sophiekovalevsky/LibreVNA/pr-previews/2/3483b7b/VNA.3dmodels/LP0603N3500ANTR.stp

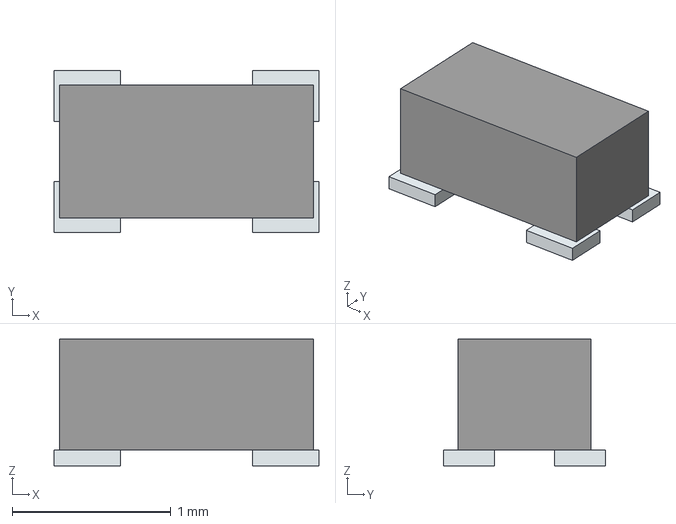
[picture p1: CAD file, 2025-08-09]
pr-previews/2/3483b7b/VNA.3dmodels/LP0603N3500ANTR.stp
1.67 x 1.02 x 0.8 mm
Pins
