sophiekovalevsky/LibreVNA/pr-previews/2/3483b7b/VNA.3dmodels/TCM1-63AX_.step

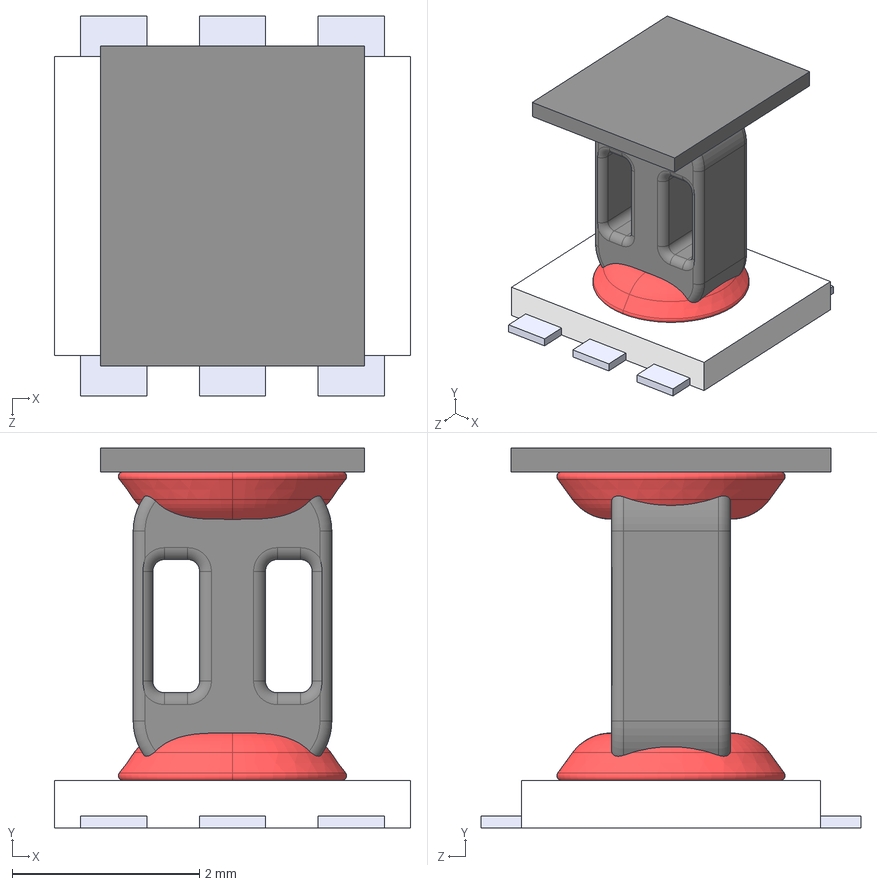
[picture p2: CAD file, 2025-08-09]
pr-previews/2/3483b7b/VNA.3dmodels/TCM1-63AX_.step
3.81 x 4.06 x 4.06 mm
