sophiekovalevsky/LibreVNA/pr-previews/2/5cce5da/VNA.3dmodels/PJ-014D.stp

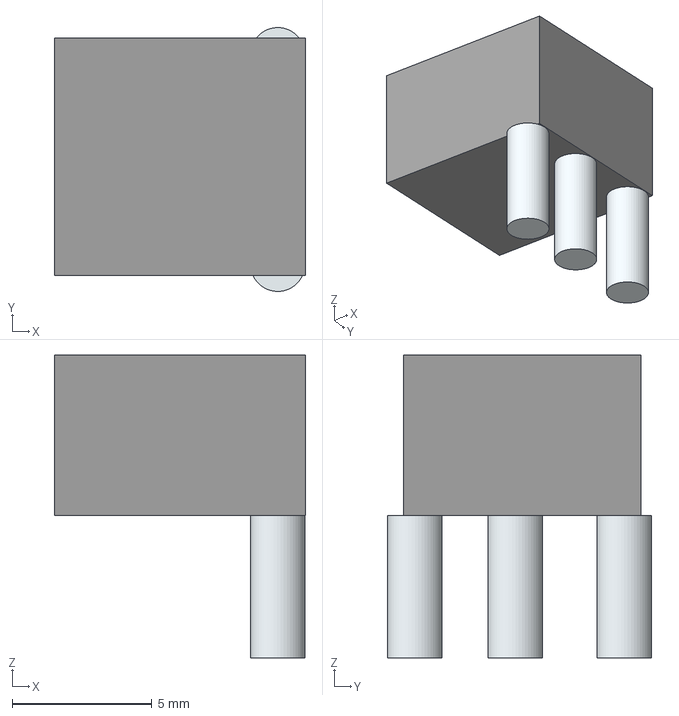
[picture p3: CAD file, 2025-08-09]
pr-previews/2/5cce5da/VNA.3dmodels/PJ-014D.stp
9.00 x 9.45 x 10.8 mm
Leads
