sophiekovalevsky/LibreVNA/pr-previews/2/3483b7b/VNA.3dmodels/PAT0816-C-3DB-T5.STEP

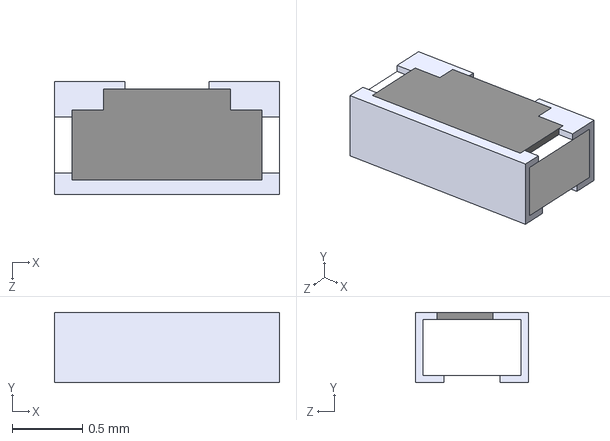
[picture p4: CAD file, 2025-08-09]
pr-previews/2/3483b7b/VNA.3dmodels/PAT0816-C-3DB-T5.STEP
1.60 x 0.5 x 0.8 mm
