sophiekovalevsky/LibreVNA/pr-previews/2/3483b7b/VNA.kicad_pcb

## KiCad design pr-previews/2/3483b7b/VNA.kicad_pcb (2025-08-09)

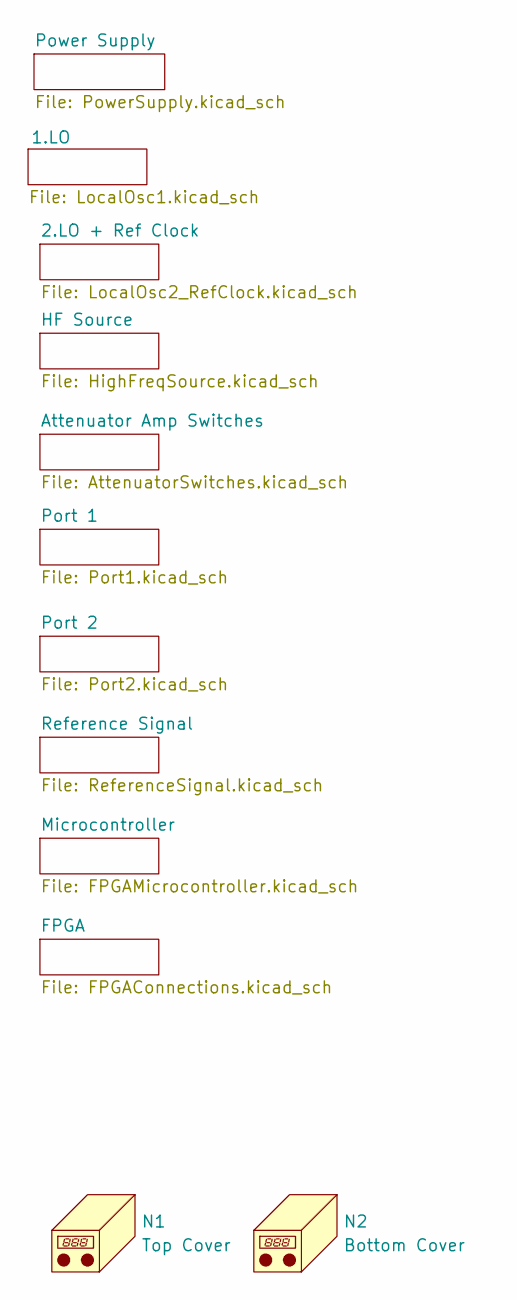
[picture p5: schematic VNA.kicad_sch, Root]

Parts:
N1: Top Cover; VNA_COVER_TOP
N2: Bottom Cover; VNA_COVER_BOTTOM

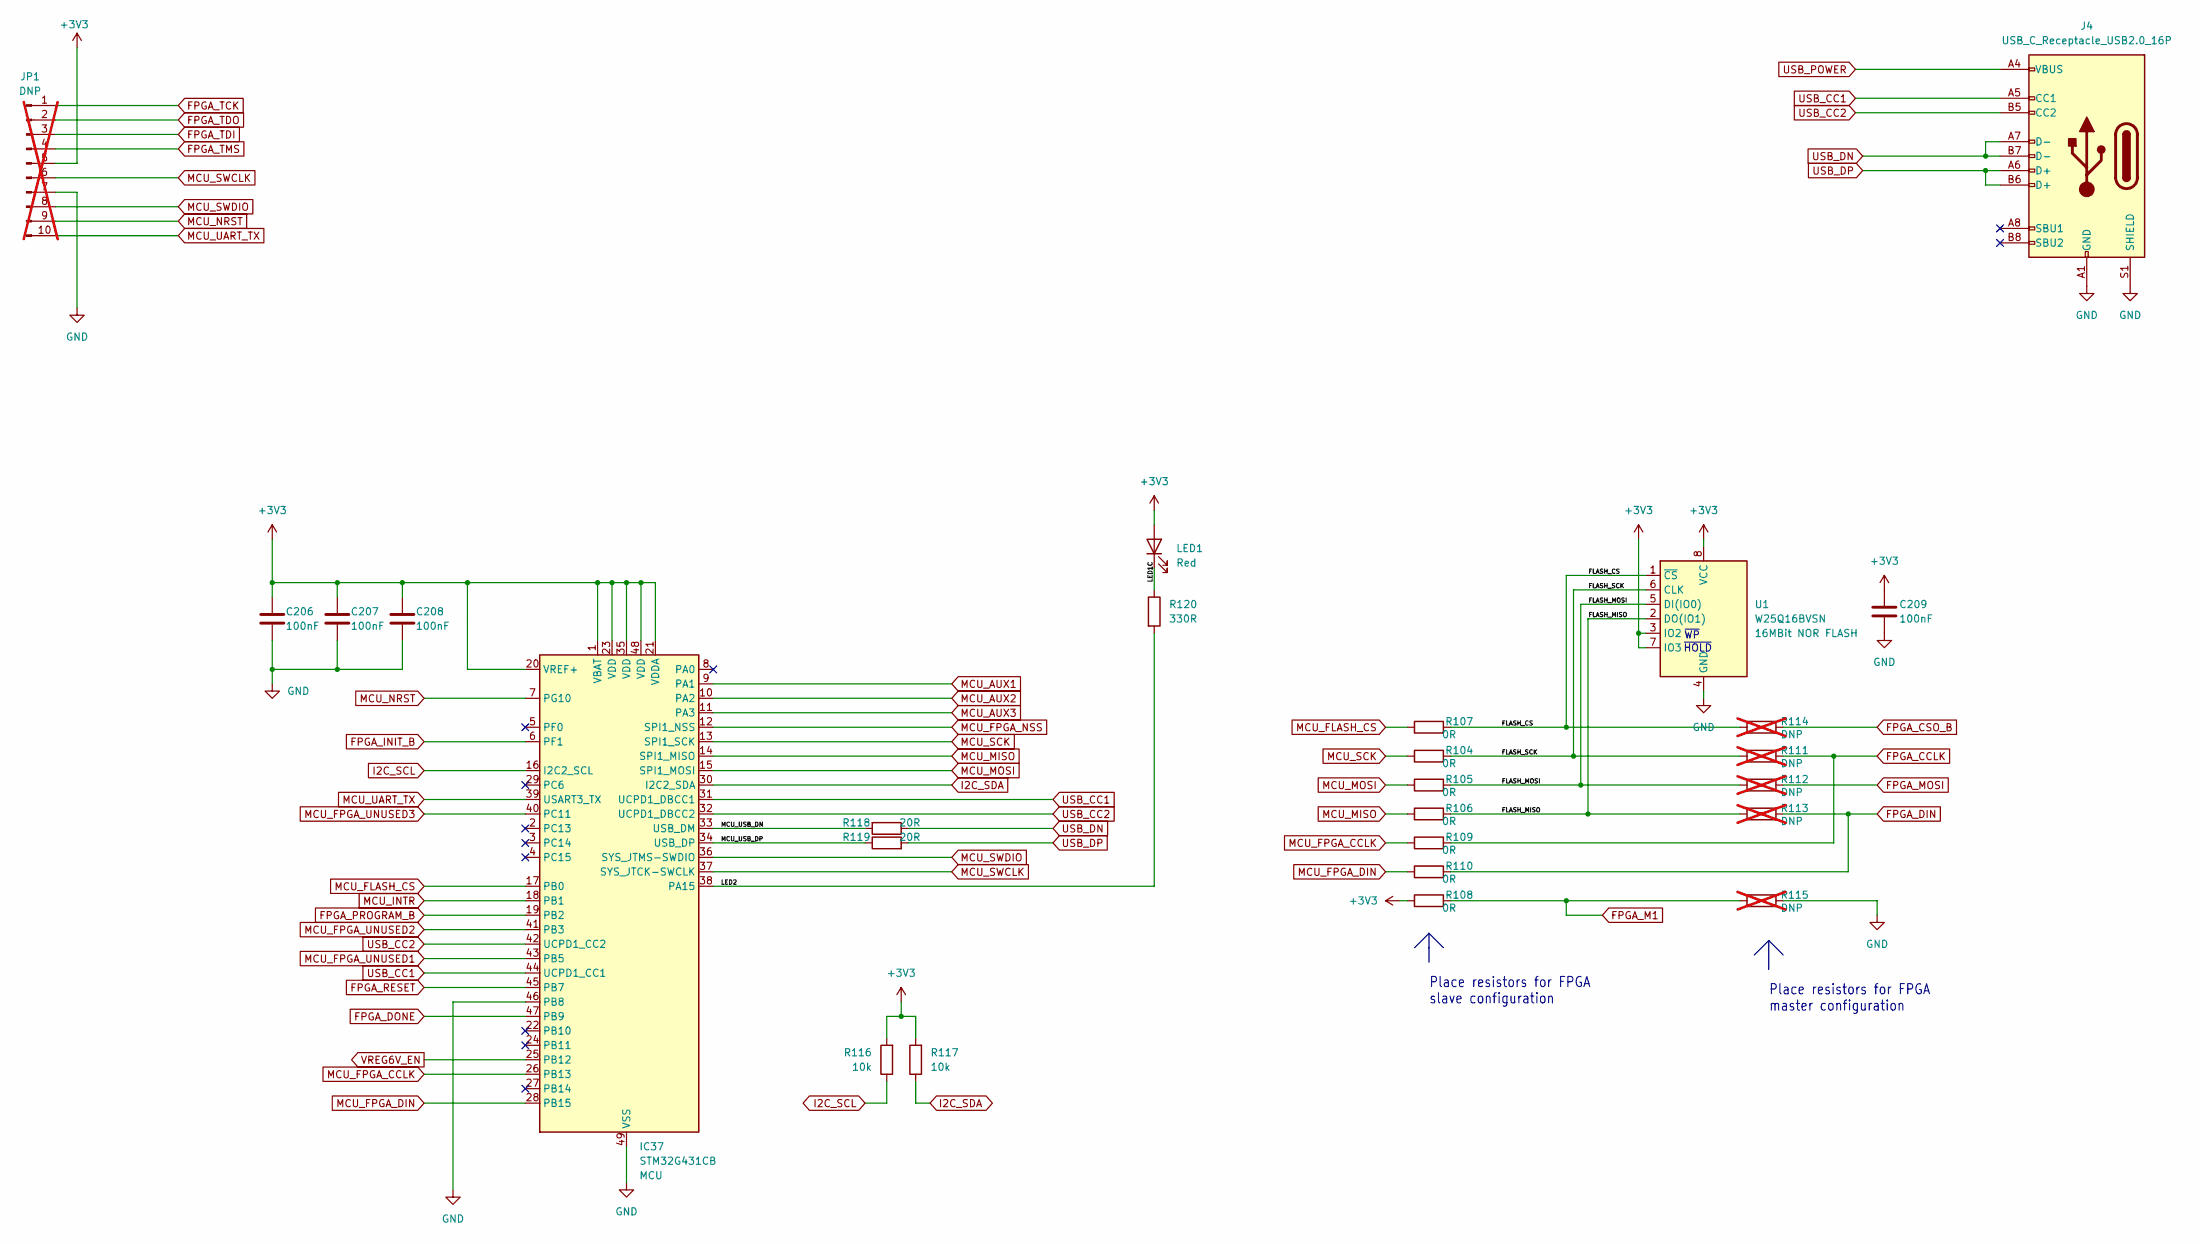
[picture p6: schematic FPGAMicrocontroller.kicad_sch, FPGA + MCU Connections]

Parts:
C206, C207, C208, C209: 100nF; C_0402_1005Metric
IC37: STM32G431CB; QFN-48-1EP_7x7mm_P0.5mm_EP5.6x5.6mm; MPN STM32G431CBU6
J4: USB_C_Receptacle_USB2.0_16P; USB_C_Receptacle_GCT_USB4105-xx-A_16P_TopMnt_Horizontal; MPN LCSC C668624
JP1: DNP; PinHeader_1x10_P2.54mm_Horizontal; not fitted
LED1: Red; LED_0603_1608Metric
R104, R105, R106, R107, R108, R109, R110: 0R; R_0402_1005Metric
R111, R112, R113, R114, R115: DNP; R_0402_1005Metric; not fitted
R116, R117: 10k; R_0402_1005Metric
R118, R119: 20R; R_0402_1005Metric
R120: 330R; R_0402_1005Metric
U1: W25Q16BVSN; SOIC-8_3.9x4.9mm_P1.27mm; MPN W25Q16JL

Connections:
+3V3: C206.1, C207.1, C208.1, C209.1, IC37.1 (VBAT), IC37.20 (VREF+), IC37.21 (VDDA), IC37.23 (VDD), IC37.35 (VDD), IC37.48 (VDD), JP1.5, LED1.2 (A), R108.1, R116.2, R117.2, U1.3 (IO2), U1.7 (IO3), U1.8 (VCC); also elsewhere on the board
/Microcontroller/FLASH_CS: R107.2, R114.1, U1.1 (~CS)
/Microcontroller/FLASH_MISO: R106.2, R113.1, U1.2 (DO(IO1))
/Microcontroller/FLASH_MOSI: R105.2, R112.1, U1.5 (DI(IO0))
/Microcontroller/FLASH_SCK: R104.2, R111.1, U1.6 (CLK)
/Microcontroller/LED1C: LED1.1 (K), R120.1
/Microcontroller/LED2: IC37.38 (PA15), R120.2
/Microcontroller/MCU_USB_DN: IC37.33 (USB_DM), R118.2
/Microcontroller/MCU_USB_DP: IC37.34 (USB_DP), R119.1
FPGA_CCLK: R109.2, R111.2; also elsewhere on the board
FPGA_CSO_B: R114.2; also elsewhere on the board
FPGA_DIN: R110.2, R113.2; also elsewhere on the board
FPGA_DONE: IC37.47 (PB9); also elsewhere on the board
FPGA_INIT_B: IC37.6 (PF1); also elsewhere on the board
FPGA_M1: R108.2, R115.1; also elsewhere on the board
FPGA_MOSI: R112.2; also elsewhere on the board
FPGA_PROGRAM_B: IC37.19 (PB2); also elsewhere on the board
FPGA_RESET: IC37.45 (PB7); also elsewhere on the board
FPGA_TCK: JP1.1; also elsewhere on the board
FPGA_TDI: JP1.3; also elsewhere on the board
FPGA_TDO: JP1.2; also elsewhere on the board
FPGA_TMS: JP1.4; also elsewhere on the board
GND: C206.2, C207.2, C208.2, C209.2, IC37.46 (PB8), IC37.49 (VSS), J4.A1 (GND), J4.A12 (GND), J4.B1 (GND), J4.B12 (GND), J4.S1 (SHIELD), JP1.7, R115.2, U1.4 (GND); also elsewhere on the board
I2C_SCL: IC37.16 (I2C2_SCL), R116.1; also elsewhere on the board
I2C_SDA: IC37.30 (I2C2_SDA), R117.1; also elsewhere on the board
MCU_AUX1: IC37.9 (PA1); also elsewhere on the board
MCU_AUX2: IC37.10 (PA2); also elsewhere on the board
MCU_AUX3: IC37.11 (PA3); also elsewhere on the board
MCU_FLASH_CS: IC37.17 (PB0), R107.1
MCU_FPGA_CCLK: IC37.26 (PB13), R109.1
MCU_FPGA_DIN: IC37.28 (PB15), R110.1
MCU_FPGA_NSS: IC37.12 (SPI1_NSS); also elsewhere on the board
MCU_FPGA_UNUSED1: IC37.43 (PB5); also elsewhere on the board
MCU_FPGA_UNUSED2: IC37.41 (PB3); also elsewhere on the board
MCU_FPGA_UNUSED3: IC37.40 (PC11); also elsewhere on the board
MCU_INTR: IC37.18 (PB1); also elsewhere on the board
MCU_MISO: IC37.14 (SPI1_MISO), R106.1; also elsewhere on the board
MCU_MOSI: IC37.15 (SPI1_MOSI), R105.1; also elsewhere on the board
MCU_NRST: IC37.7 (PG10), JP1.9
MCU_SCK: IC37.13 (SPI1_SCK), R104.1; also elsewhere on the board
MCU_SWCLK: IC37.37 (SYS_JTCK-SWCLK), JP1.6
MCU_SWDIO: IC37.36 (SYS_JTMS-SWDIO), JP1.8
MCU_UART_TX: IC37.39 (USART3_TX), JP1.10
USB_CC1: IC37.31 (UCPD1_DBCC1), IC37.44 (UCPD1_CC1), J4.A5 (CC1)
USB_CC2: IC37.32 (UCPD1_DBCC2), IC37.42 (UCPD1_CC2), J4.B5 (CC2)
USB_DN: J4.A7 (D-), J4.B7 (D-), R118.1
USB_DP: J4.A6 (D+), J4.B6 (D+), R119.2
USB_POWER: J4.A4 (VBUS), J4.A9 (VBUS), J4.B4 (VBUS), J4.B9 (VBUS); also elsewhere on the board
VREG6V_EN: IC37.25 (PB12); also elsewhere on the board

Notes on the sheet:
Place resistors for FPGA slave configuration
~{WP}
Place resistors for FPGA master configuration
~{HOLD}

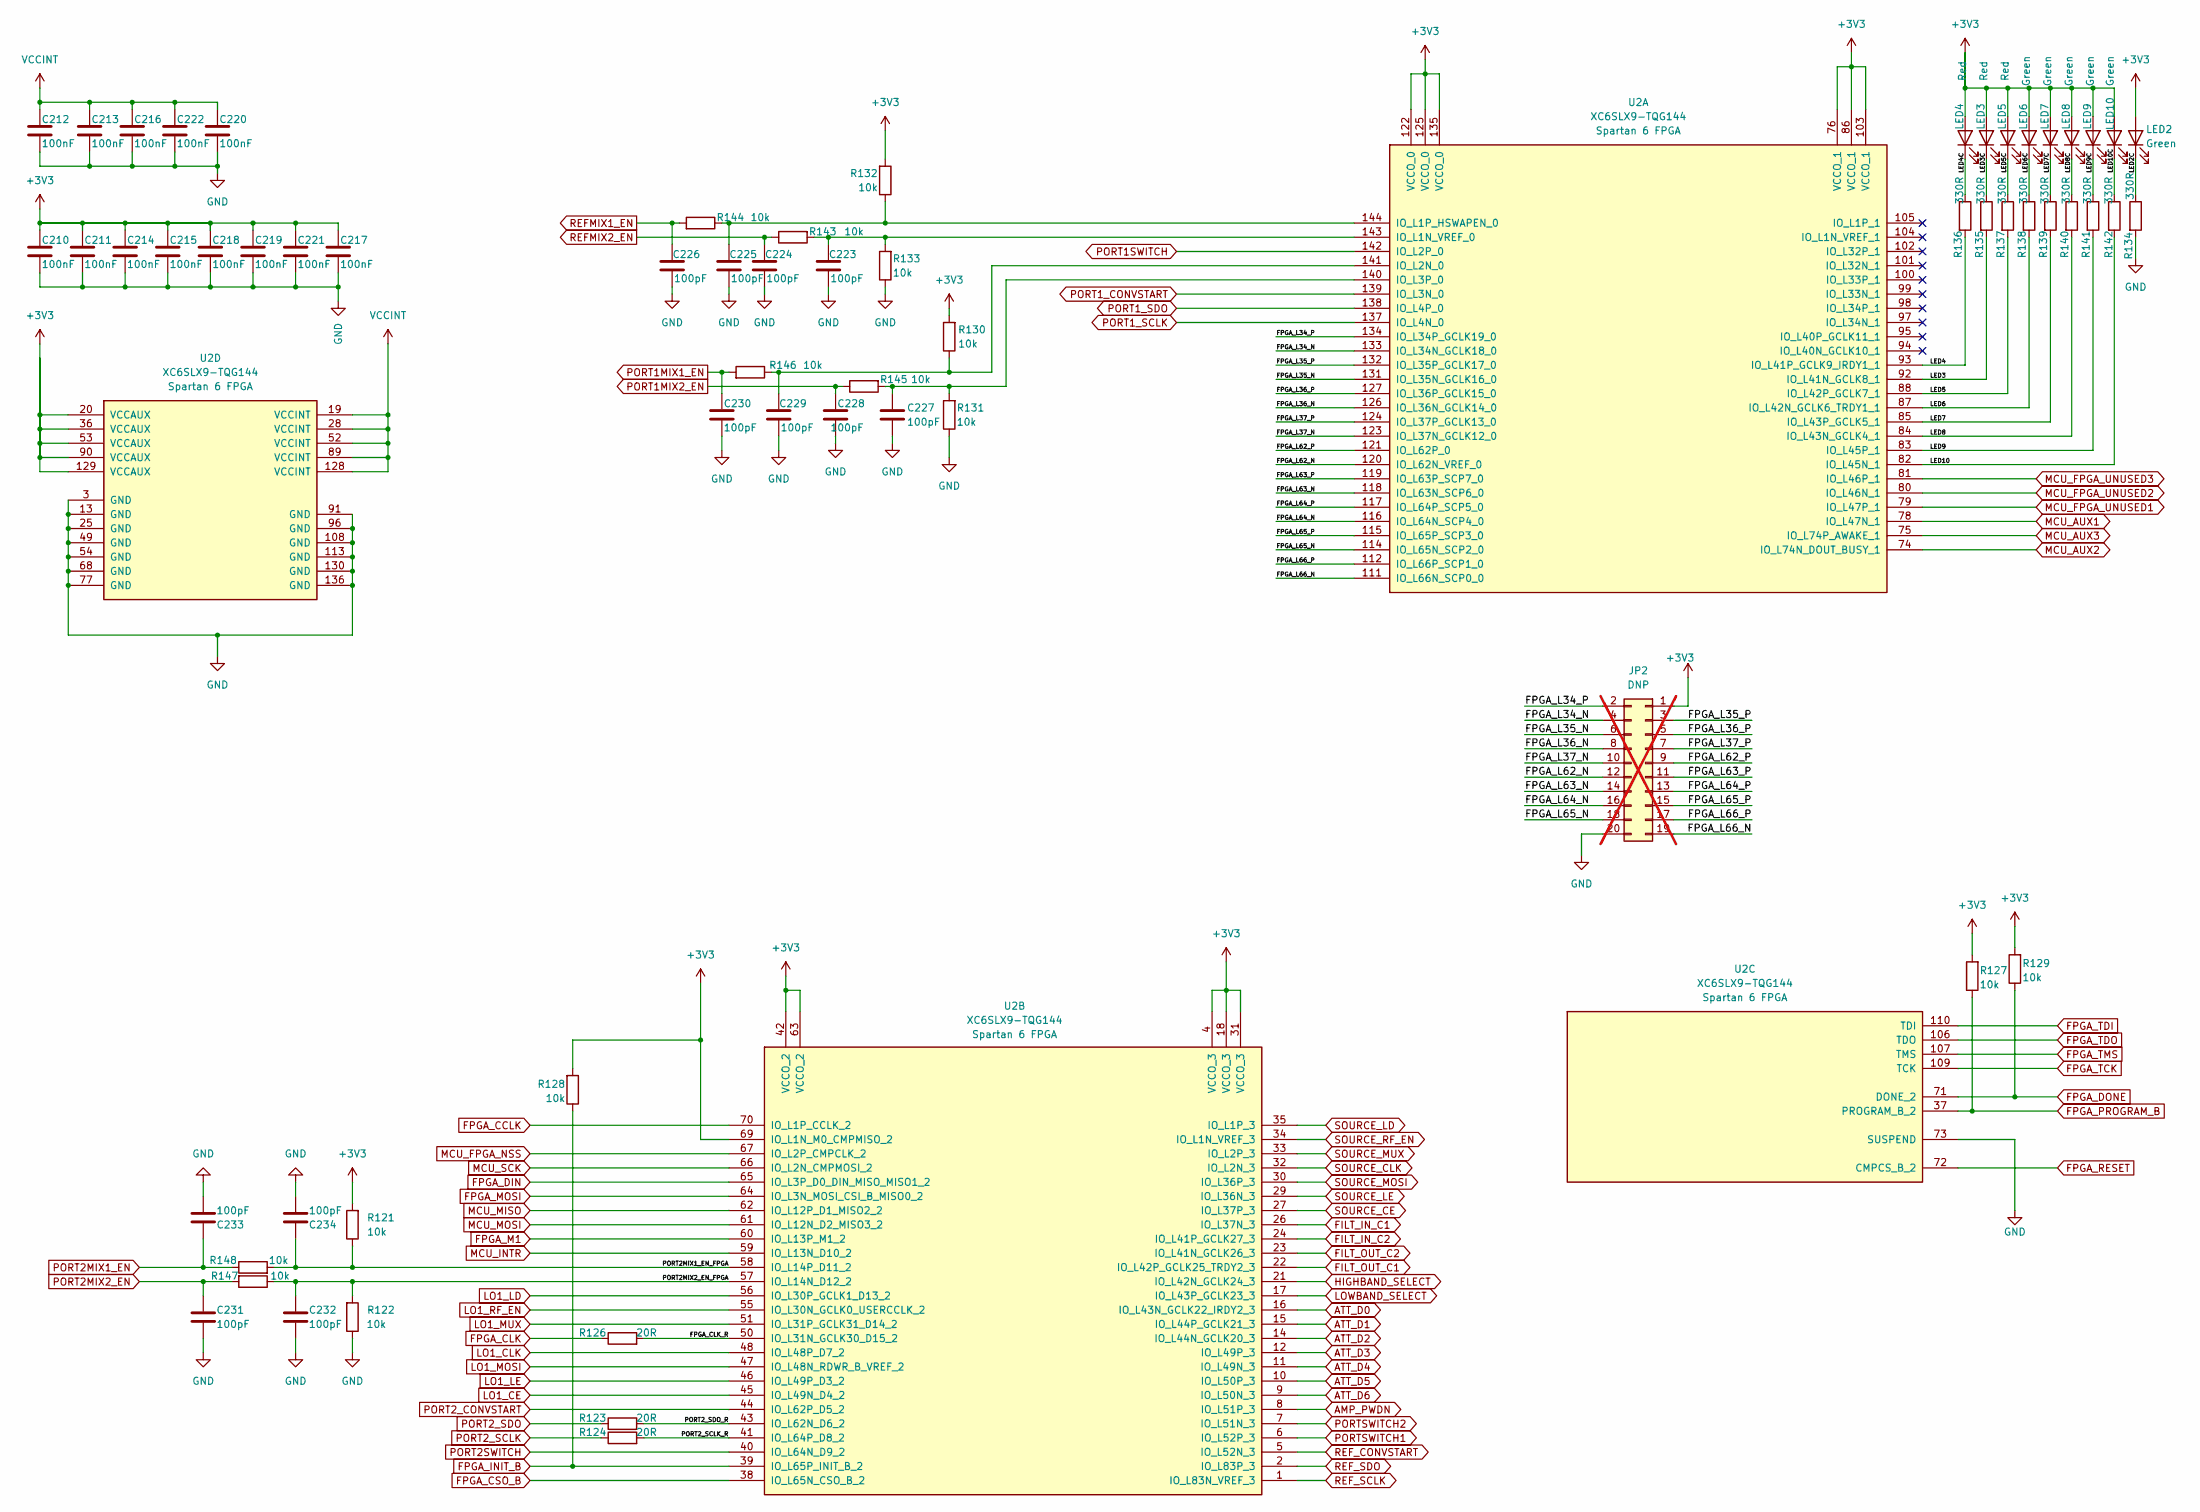
[picture p7: schematic FPGAConnections.kicad_sch, FPGA Connections]

Parts:
C210, C211, C212, C213, C214, C215, C216, C217, C218, C219, C220, C221, C222: 100nF; C_0402_1005Metric
C223, C224, C225, C226, C227, C228, C229, C230, C231, C232, C233, C234: 100pF; C_0402_1005Metric
JP2: DNP; PinHeader_2x10_P2.54mm_Vertical; not fitted
LED2, LED6, LED7, LED8, LED9, LED10: Green; LED_0603_1608Metric
LED3, LED4, LED5: Red; LED_0603_1608Metric
R121, R122, R127, R128, R129, R130, R131, R132, R133, R143, R144, R145, R146, R147, R148: 10k; R_0402_1005Metric
R123, R124, R126: 20R; R_0402_1005Metric
R134, R135, R136, R137, R138, R139, R140, R141, R142: 330R; R_0402_1005Metric
U2: XC6SLX9-TQG144; TQFP-144_20x20mm_P0.5mm; MPN XC6SLX9-2TQG144

Connections:
+3V3: C210.1, C211.1, C214.1, C215.1, C217.1, C218.1, C219.1, C221.1, JP2.1, LED2.2 (A), LED3.2 (A), LED4.2 (A), LED5.2 (A), LED6.2 (A), LED7.2 (A), LED8.2 (A), LED9.2 (A), LED10.2 (A), R121.2, R127.2, R128.2, R129.2, R130.2, R132.2, U2.4 (VCCO_3), U2.18 (VCCO_3), U2.20 (VCCAUX), U2.31 (VCCO_3), U2.36 (VCCAUX), U2.42 (VCCO_2), U2.53 (VCCAUX), U2.63 (VCCO_2), U2.69 (IO_L1N_M0_CMPMISO_2), U2.76 (VCCO_1), U2.86 (VCCO_1), U2.90 (VCCAUX), U2.103 (VCCO_1), U2.122 (VCCO_0), U2.125 (VCCO_0), U2.129 (VCCAUX), U2.135 (VCCO_0); also elsewhere on the board
/FPGA/FPGA_CLK_R: R126.2, U2.50 (IO_L31N_GCLK30_D15_2)
/FPGA/FPGA_L34_N: JP2.4, U2.133 (IO_L34N_GCLK18_0)
/FPGA/FPGA_L34_P: JP2.2, U2.134 (IO_L34P_GCLK19_0)
/FPGA/FPGA_L35_N: JP2.6, U2.131 (IO_L35N_GCLK16_0)
/FPGA/FPGA_L35_P: JP2.3, U2.132 (IO_L35P_GCLK17_0)
/FPGA/FPGA_L36_N: JP2.8, U2.126 (IO_L36N_GCLK14_0)
/FPGA/FPGA_L36_P: JP2.5, U2.127 (IO_L36P_GCLK15_0)
/FPGA/FPGA_L37_N: JP2.10, U2.123 (IO_L37N_GCLK12_0)
/FPGA/FPGA_L37_P: JP2.7, U2.124 (IO_L37P_GCLK13_0)
/FPGA/FPGA_L62_N: JP2.12, U2.120 (IO_L62N_VREF_0)
/FPGA/FPGA_L62_P: JP2.9, U2.121 (IO_L62P_0)
/FPGA/FPGA_L63_N: JP2.14, U2.118 (IO_L63N_SCP6_0)
/FPGA/FPGA_L63_P: JP2.11, U2.119 (IO_L63P_SCP7_0)
/FPGA/FPGA_L64_N: JP2.16, U2.116 (IO_L64N_SCP4_0)
/FPGA/FPGA_L64_P: JP2.13, U2.117 (IO_L64P_SCP5_0)
/FPGA/FPGA_L65_N: JP2.18, U2.114 (IO_L65N_SCP2_0)
/FPGA/FPGA_L65_P: JP2.15, U2.115 (IO_L65P_SCP3_0)
/FPGA/FPGA_L66_N: JP2.19, U2.111 (IO_L66N_SCP0_0)
/FPGA/FPGA_L66_P: JP2.17, U2.112 (IO_L66P_SCP1_0)
/FPGA/LED2C: LED2.1 (K), R134.1
/FPGA/LED3: R135.2, U2.92 (IO_L41N_GCLK8_1)
/FPGA/LED3C: LED3.1 (K), R135.1
/FPGA/LED4: R136.2, U2.93 (IO_L41P_GCLK9_IRDY1_1)
/FPGA/LED4C: LED4.1 (K), R136.1
/FPGA/LED5: R137.2, U2.88 (IO_L42P_GCLK7_1)
/FPGA/LED5C: LED5.1 (K), R137.1
/FPGA/LED6: R138.2, U2.87 (IO_L42N_GCLK6_TRDY1_1)
/FPGA/LED6C: LED6.1 (K), R138.1
/FPGA/LED7: R139.2, U2.85 (IO_L43P_GCLK5_1)
/FPGA/LED7C: LED7.1 (K), R139.1
/FPGA/LED8: R140.2, U2.84 (IO_L43N_GCLK4_1)
/FPGA/LED8C: LED8.1 (K), R140.1
/FPGA/LED9: R141.2, U2.83 (IO_L45P_1)
/FPGA/LED9C: LED9.1 (K), R141.1
/FPGA/LED10: R142.2, U2.82 (IO_L45N_1)
/FPGA/LED10C: LED10.1 (K), R142.1
/FPGA/PORT2MIX1_EN_FPGA: C234.1, R121.1, R148.2, U2.58 (IO_L14P_D11_2)
/FPGA/PORT2MIX2_EN_FPGA: C232.1, R122.2, R147.1, U2.57 (IO_L14N_D12_2)
/FPGA/PORT2_SCLK_R: R124.2, U2.41 (IO_L64P_D8_2)
/FPGA/PORT2_SDO_R: R123.2, U2.43 (IO_L62N_D6_2)
AMP_PWDN: U2.8 (IO_L51P_3); also elsewhere on the board
ATT_D0: U2.16 (IO_L43N_GCLK22_IRDY2_3); also elsewhere on the board
ATT_D1: U2.15 (IO_L44P_GCLK21_3); also elsewhere on the board
ATT_D2: U2.14 (IO_L44N_GCLK20_3); also elsewhere on the board
ATT_D3: U2.12 (IO_L49P_3); also elsewhere on the board
ATT_D4: U2.11 (IO_L49N_3); also elsewhere on the board
ATT_D5: U2.10 (IO_L50P_3); also elsewhere on the board
ATT_D6: U2.9 (IO_L50N_3); also elsewhere on the board
FILT_IN_C1: U2.26 (IO_L37N_3); also elsewhere on the board
FILT_IN_C2: U2.24 (IO_L41P_GCLK27_3); also elsewhere on the board
FILT_OUT_C1: U2.22 (IO_L42P_GCLK25_TRDY2_3); also elsewhere on the board
FILT_OUT_C2: U2.23 (IO_L41N_GCLK26_3); also elsewhere on the board
FPGA_CCLK: U2.70 (IO_L1P_CCLK_2); also elsewhere on the board
FPGA_CLK: R126.1; also elsewhere on the board
FPGA_CSO_B: U2.38 (IO_L65N_CSO_B_2); also elsewhere on the board
FPGA_DIN: U2.65 (IO_L3P_D0_DIN_MISO_MISO1_2); also elsewhere on the board
FPGA_DONE: R129.1, U2.71 (DONE_2); also elsewhere on the board
FPGA_INIT_B: R128.1, U2.39 (IO_L65P_INIT_B_2); also elsewhere on the board
FPGA_M1: U2.60 (IO_L13P_M1_2); also elsewhere on the board
FPGA_MOSI: U2.64 (IO_L3N_MOSI_CSI_B_MISO0_2); also elsewhere on the board
FPGA_PROGRAM_B: R127.1, U2.37 (PROGRAM_B_2); also elsewhere on the board
FPGA_RESET: U2.72 (CMPCS_B_2); also elsewhere on the board
FPGA_TCK: U2.109 (TCK); also elsewhere on the board
FPGA_TDI: U2.110 (TDI); also elsewhere on the board
FPGA_TDO: U2.106 (TDO); also elsewhere on the board
FPGA_TMS: U2.107 (TMS); also elsewhere on the board
GND: C210.2, C211.2, C212.2, C213.2, C214.2, C215.2, C216.2, C217.2, C218.2, C219.2, C220.2, C221.2, C222.2, C223.2, C224.2, C225.2, C226.2, C227.2, C228.2, C229.2, C230.2, C231.2, C232.2, C233.2, C234.2, JP2.20, R122.1, R131.1, R133.1, R134.2, U2.3 (GND), U2.13 (GND), U2.25 (GND), U2.49 (GND), U2.54 (GND), U2.68 (GND), U2.73 (SUSPEND), U2.77 (GND), U2.91 (GND), U2.96 (GND), U2.108 (GND), U2.113 (GND), U2.130 (GND), U2.136 (GND); also elsewhere on the board
HIGHBAND_SELECT: U2.21 (IO_L42N_GCLK24_3); also elsewhere on the board
LO1_CE: U2.45 (IO_L49N_D4_2); also elsewhere on the board
LO1_CLK: U2.48 (IO_L48P_D7_2); also elsewhere on the board
LO1_LD: U2.56 (IO_L30P_GCLK1_D13_2); also elsewhere on the board
LO1_LE: U2.46 (IO_L49P_D3_2); also elsewhere on the board
LO1_MOSI: U2.47 (IO_L48N_RDWR_B_VREF_2); also elsewhere on the board
LO1_MUX: U2.51 (IO_L31P_GCLK31_D14_2); also elsewhere on the board
LO1_RF_EN: U2.55 (IO_L30N_GCLK0_USERCCLK_2); also elsewhere on the board
LOWBAND_SELECT: U2.17 (IO_L43P_GCLK23_3); also elsewhere on the board
MCU_AUX1: U2.78 (IO_L47N_1); also elsewhere on the board
MCU_AUX2: U2.74 (IO_L74N_DOUT_BUSY_1); also elsewhere on the board
MCU_AUX3: U2.75 (IO_L74P_AWAKE_1); also elsewhere on the board
MCU_FPGA_NSS: U2.67 (IO_L2P_CMPCLK_2); also elsewhere on the board
MCU_FPGA_UNUSED1: U2.79 (IO_L47P_1); also elsewhere on the board
MCU_FPGA_UNUSED2: U2.80 (IO_L46N_1); also elsewhere on the board
MCU_FPGA_UNUSED3: U2.81 (IO_L46P_1); also elsewhere on the board
MCU_INTR: U2.59 (IO_L13N_D10_2); also elsewhere on the board
MCU_MISO: U2.62 (IO_L12P_D1_MISO2_2); also elsewhere on the board
MCU_MOSI: U2.61 (IO_L12N_D2_MISO3_2); also elsewhere on the board
MCU_SCK: U2.66 (IO_L2N_CMPMOSI_2); also elsewhere on the board
unnamed: C223.1, R133.2, R143.2, U2.143 (IO_L1N_VREF_0)
unnamed: C225.1, R132.1, R144.1, U2.144 (IO_L1P_HSWAPEN_0)
unnamed: C229.1, R130.1, R146.1, U2.141 (IO_L2N_0)
unnamed: C227.1, R131.2, R145.2, U2.140 (IO_L3P_0)
PORT1MIX1_EN: C230.1, R146.2; also elsewhere on the board
PORT1MIX2_EN: C228.1, R145.1; also elsewhere on the board
PORT1SWITCH: U2.142 (IO_L2P_0); also elsewhere on the board
PORT1_CONVSTART: U2.139 (IO_L3N_0); also elsewhere on the board
PORT1_SCLK: U2.137 (IO_L4N_0); also elsewhere on the board
PORT1_SDO: U2.138 (IO_L4P_0); also elsewhere on the board
PORT2MIX1_EN: C233.1, R148.1; also elsewhere on the board
PORT2MIX2_EN: C231.1, R147.2; also elsewhere on the board
PORT2SWITCH: U2.40 (IO_L64N_D9_2); also elsewhere on the board
PORT2_CONVSTART: U2.44 (IO_L62P_D5_2); also elsewhere on the board
PORT2_SCLK: R124.1; also elsewhere on the board
PORT2_SDO: R123.1; also elsewhere on the board
PORTSWITCH1: U2.6 (IO_L52P_3); also elsewhere on the board
PORTSWITCH2: U2.7 (IO_L51N_3); also elsewhere on the board
REFMIX1_EN: C226.1, R144.2; also elsewhere on the board
REFMIX2_EN: C224.1, R143.1; also elsewhere on the board
REF_CONVSTART: U2.5 (IO_L52N_3); also elsewhere on the board
REF_SCLK: U2.1 (IO_L83N_VREF_3); also elsewhere on the board
REF_SDO: U2.2 (IO_L83P_3); also elsewhere on the board
SOURCE_CE: U2.27 (IO_L37P_3); also elsewhere on the board
SOURCE_CLK: U2.32 (IO_L2N_3); also elsewhere on the board
SOURCE_LD: U2.35 (IO_L1P_3); also elsewhere on the board
SOURCE_LE: U2.29 (IO_L36N_3); also elsewhere on the board
SOURCE_MOSI: U2.30 (IO_L36P_3); also elsewhere on the board
SOURCE_MUX: U2.33 (IO_L2P_3); also elsewhere on the board
SOURCE_RF_EN: U2.34 (IO_L1N_VREF_3); also elsewhere on the board
VCCINT: C212.1, C213.1, C216.1, C220.1, C222.1, U2.19 (VCCINT), U2.28 (VCCINT), U2.52 (VCCINT), U2.89 (VCCINT), U2.128 (VCCINT); also elsewhere on the board

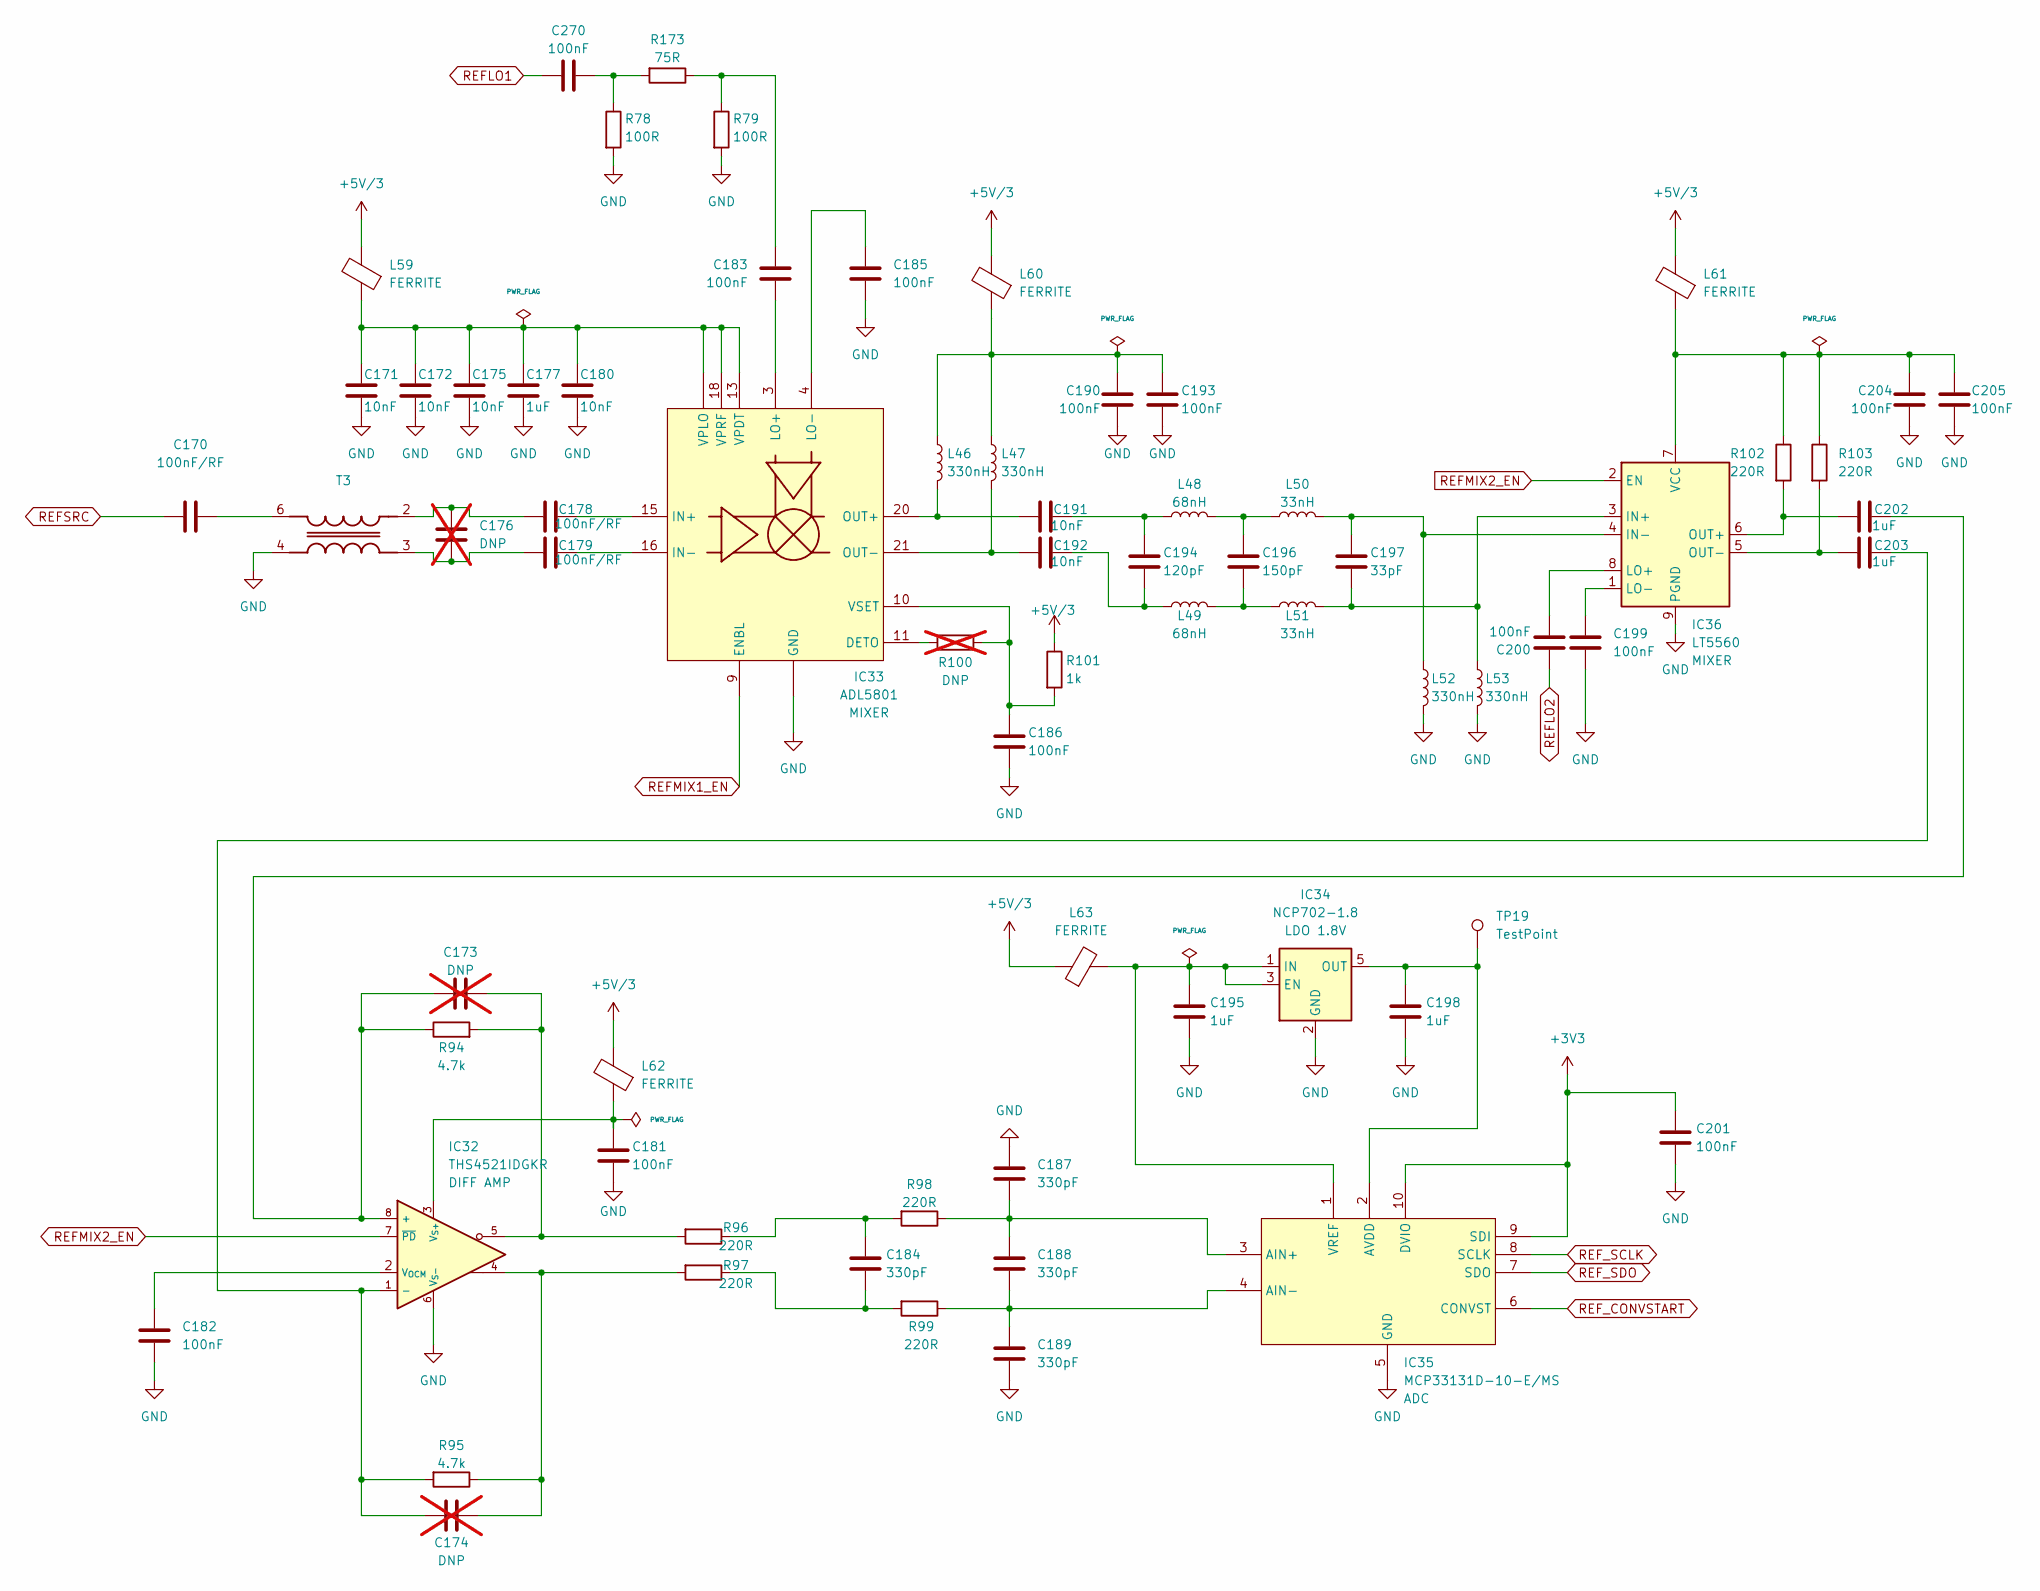
[picture p8: schematic ReferenceSignal.kicad_sch, Reference Signal]

Parts:
C170, C178, C179: 100nF/RF; C_0402_1005Metric
C171, C172, C175, C180, C191, C192: 10nF; C_0402_1005Metric
C173, C174, C176: DNP; C_0402_1005Metric; not fitted
C177, C195, C198, C202, C203: 1uF; C_0402_1005Metric
C181, C182, C183, C185, C186, C190, C193, C199, C200, C201, C204, C205, C270: 100nF; C_0402_1005Metric
C184, C187, C188, C189: 330pF; C_0402_1005Metric
C194: 120pF; C_0402_1005Metric
C196: 150pF; C_0402_1005Metric
C197: 33pF; C_0402_1005Metric
IC32: THS4521IDGKR; VSSOP-8_3.0x3.0mm_P0.65mm; MPN THS4521IDGKR
IC33: ADL5801; QFN-24-1EP_4x4mm_P0.5mm_EP2.6x2.6mm; MPN ADL5801
IC34: NCP702-1.8; SOT-23-5; MPN NCP702SN18T1G
IC35: MCP33131D-10-E/MS; VSSOP-10_3x3mm_P0.5mm; MPN MCP33131D-10-E/MS
IC36: LT5560; WSON-8-1EP_3x3mm_P0.5mm_EP1.45x2.4mm; MPN LT5560EDD
L46, L47, L52, L53: 330nH; L_0402_1005Metric; MPN LQW15CNR33J10D
L48, L49: 68nH; L_0402_1005Metric; MPN LQW15AN68NJ00D
L50, L51: 33nH; L_0402_1005Metric; MPN LQW15AN33NJ00D
L59, L60, L61, L62, L63: FERRITE; R_0402_1005Metric; MPN BLM15AX601SN1
R78, R79: 100R; R_0402_1005Metric
R94, R95: 4.7k; R_0402_1005Metric
R96, R97, R98, R99, R102, R103: 220R; R_0402_1005Metric
R100: DNP; R_0402_1005Metric; not fitted
R101: 1k; R_0402_1005Metric
R173: 75R; R_0402_1005Metric
T3: B012-617DB-1-63-B331; EASTEVER_BALUN; MPN B012-617DB-1-63-B331
TP19: TestPoint; B1,27

Connections:
+3V3: C201.2, IC35.9 (SDI), IC35.10 (DVIO); also elsewhere on the board
+5V/3: L59.2, L60.2, L61.2, L62.2, L63.1, R101.1; also elsewhere on the board
GND: C171.2, C172.2, C175.2, C177.2, C180.2, C181.1, C182.2, C185.2, C186.1, C187.1, C189.2, C190.2, C193.2, C195.2, C198.2, C199.1, C201.1, C204.1, C205.1, IC32.6 (V_{S-}), IC33.1 (GND), IC33.2 (GND), IC33.5 (GND), IC33.6 (GND), IC33.8 (GND), IC33.12 (GND), IC33.14 (GND), IC33.17 (GND), IC33.19 (GND), IC33.23 (GND), IC33.25 (GND), IC34.2 (GND), IC35.5 (GND), IC36.9 (PGND), L52.2, L53.2, R78.2, R79.2, T3.4 (OUT+); also elsewhere on the board
unnamed: C173.2, IC32.5, R94.2, R96.2
unnamed: C174.1, IC32.4, R95.1, R97.2
unnamed: C183.1, R79.1, R173.1
unnamed: C184.1, R96.1, R98.2
unnamed: C184.2, R97.1, R99.2
unnamed: C190.1, C193.1, L46.1, L47.1, L60.1
unnamed: C191.2, C194.1, L48.1
unnamed: C192.2, C194.2, L49.1
unnamed: C196.1, L48.2, L50.1
unnamed: C196.2, L49.2, L51.1
unnamed: C270.2, R78.1, R173.2
unnamed: C173.1, C202.2, IC32.8 (+), R94.1
unnamed: C174.2, C203.2, IC32.1 (-), R95.2
unnamed: C182.1, IC32.2 (V_{OCM})
unnamed: C181.2, IC32.3 (V_{S+}), L62.1
unnamed: IC33.11 (DETO), R100.2
unnamed: C178.2, IC33.15 (IN+)
unnamed: C179.2, IC33.16 (IN-)
unnamed: C183.2, IC33.3 (LO+)
unnamed: C185.1, IC33.4 (LO-)
unnamed: C191.1, IC33.20 (OUT+), L46.2
unnamed: C192.1, IC33.21 (OUT-), L47.2
unnamed: C171.1, C172.1, C175.1, C177.1, C180.1, IC33.7 (VPLO), IC33.13 (VPDT), IC33.18 (VPRF), IC33.24 (VPLO), L59.1
unnamed: C186.2, IC33.10 (VSET), R100.1, R101.2
unnamed: C195.1, IC34.1 (IN), IC34.3 (EN), IC35.1 (VREF), L63.2
unnamed: C198.1, IC34.5 (OUT), IC35.2 (AVDD), TP19.1
unnamed: C187.2, C188.1, IC35.3 (AIN+), R98.1
unnamed: C188.2, C189.1, IC35.4 (AIN-), R99.1
unnamed: C197.2, IC36.3 (IN+), L51.2, L53.1
unnamed: C197.1, IC36.4 (IN-), L50.2, L52.1
unnamed: C200.2, IC36.8 (LO+)
unnamed: C199.2, IC36.1 (LO-)
unnamed: C202.1, IC36.6 (OUT+), R102.2
unnamed: C203.1, IC36.5 (OUT-), R103.2
unnamed: C204.2, C205.2, IC36.7 (VCC), L61.1, R102.1, R103.1
unnamed: C176.1, C179.1, T3.3 (IN+)
unnamed: C176.2, C178.1, T3.2 (IN-)
unnamed: C170.2, T3.6 (OUT-)
REFLO1: C270.1; also elsewhere on the board
REFLO2: C200.1; also elsewhere on the board
REFMIX1_EN: IC33.9 (ENBL); also elsewhere on the board
REFMIX2_EN: IC32.7 (~PD), IC36.2 (EN); also elsewhere on the board
REFSRC: C170.1; also elsewhere on the board
REF_CONVSTART: IC35.6 (CONVST); also elsewhere on the board
REF_SCLK: IC35.8 (SCLK); also elsewhere on the board
REF_SDO: IC35.7 (SDO); also elsewhere on the board
