sophiekovalevsky/LibreVNA/pr-previews/2/3483b7b/VNA.kicad_pcb

## KiCad design pr-previews/2/3483b7b/VNA.kicad_pcb (continued)

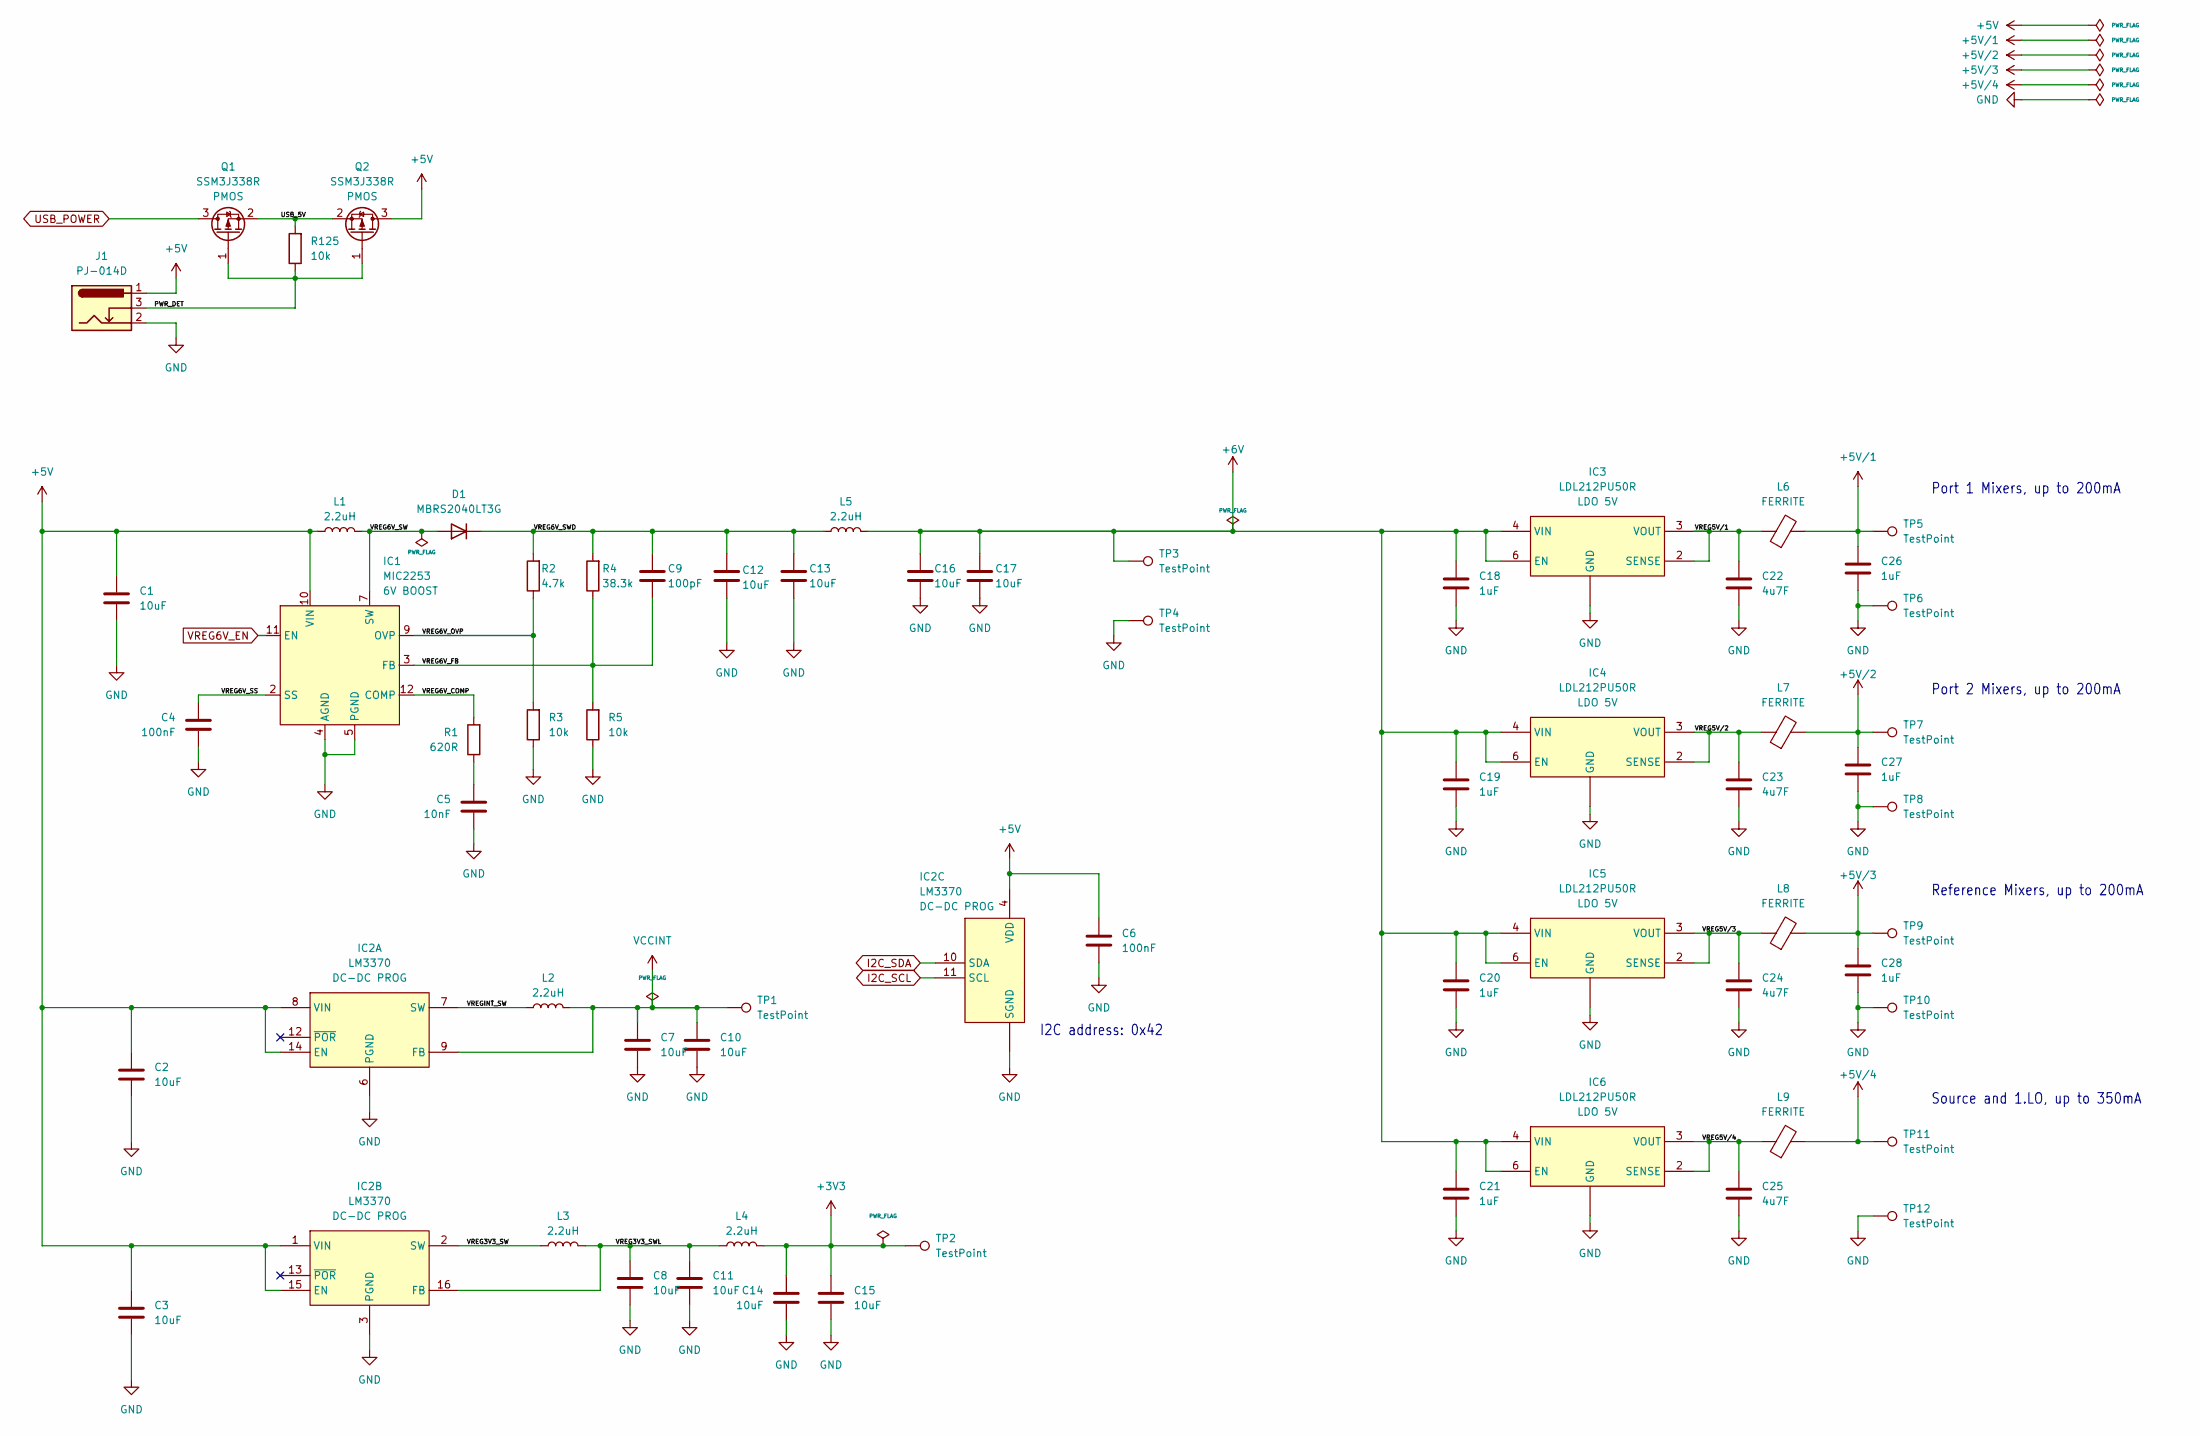
[picture p9: schematic PowerSupply.kicad_sch, Power Supply]

Parts:
C1, C2, C3, C7, C8, C10, C11, C12, C13, C14, C15, C16, C17: 10uF; C_1206_3216Metric
C4, C6: 100nF; C_0402_1005Metric
C5: 10nF; C_0402_1005Metric
C9: 100pF; C_0402_1005Metric
C18, C19, C20, C21, C26, C27, C28: 1uF; C_0603_1608Metric
C22, C23, C24, C25: 4u7F; C_0603_1608Metric
D1: MBRS2040LT3G; D_SMB; MPN MBRS2040LT3G
IC1: MIC2253; DFN-12-1EP_3x3mm_P0.45mm_EP1.66x2.38mm; MPN MIC2253-06YML
IC2: LM3370; DFN-16-1EP_4x5mm_P0.5mm_EP2.44x4.34mm; MPN LM3370SD-3021
IC3, IC4, IC5, IC6: LDL212PU50R; WSON-6-1EP_3x3mm_P0.95mm; MPN LDL212PU50R
J1: PJ-014D; MPN PJ-014D
L1, L2, L3, L4, L5: 2.2uH; L_Sunlord_SWPA5040S; MPN SRN5040-2R2Y
L6, L7, L8, L9: FERRITE; R_0402_1005Metric; MPN BLM15AX601SN1
Q1, Q2: SSM3J338R; SOT-23; MPN SSM3J338R
R1: 620R; R_0402_1005Metric
R2: 4.7k; R_0402_1005Metric
R3, R5, R125: 10k; R_0402_1005Metric
R4: 38.3k; R_0402_1005Metric
TP1, TP2, TP3, TP4, TP5, TP6, TP7, TP8, TP9, TP10, TP11, TP12: TestPoint; B1,27

Connections:
+3V3: C14.1, C15.1, L4.2, TP2.1; also elsewhere on the board
+5V: C1.1, C2.1, C3.1, C6.2, IC1.10 (VIN), IC2.1 (VIN), IC2.4 (VDD), IC2.8 (VIN), IC2.14 (EN), IC2.15 (EN), J1.1, L1.1, Q2.3 (D)
+5V/1: C26.2, L6.2, TP5.1; also elsewhere on the board
+5V/2: C27.2, L7.2, TP7.1; also elsewhere on the board
+5V/3: C28.2, L8.2, TP9.1; also elsewhere on the board
+5V/4: L9.2, TP11.1; also elsewhere on the board
+6V: C16.1, C17.1, C18.2, C19.2, C20.2, C21.2, IC3.4 (VIN), IC3.6 (EN), IC4.4 (VIN), IC4.6 (EN), IC5.4 (VIN), IC5.6 (EN), IC6.4 (VIN), IC6.6 (EN), L5.2, TP3.1
/Power Supply/PWR_DET: J1.3, Q1.1 (G), Q2.1 (G), R125.1
/Power Supply/USB_5V: Q1.2 (S), Q2.2 (S), R125.2
/Power Supply/VREG3V3_SW: IC2.2 (SW), L3.1
/Power Supply/VREG3V3_SWL: C8.1, C11.1, IC2.16 (FB), L3.2, L4.1
/Power Supply/VREG5V/1: C22.2, IC3.2 (SENSE), IC3.3 (VOUT), L6.1
/Power Supply/VREG5V/2: C23.2, IC4.2 (SENSE), IC4.3 (VOUT), L7.1
/Power Supply/VREG5V/3: C24.2, IC5.2 (SENSE), IC5.3 (VOUT), L8.1
/Power Supply/VREG5V/4: C25.2, IC6.2 (SENSE), IC6.3 (VOUT), L9.1
/Power Supply/VREG6V_COMP: IC1.12 (COMP), R1.2
/Power Supply/VREG6V_FB: C9.2, IC1.3 (FB), R4.1, R5.2
/Power Supply/VREG6V_OVP: IC1.9 (OVP), R2.1, R3.2
/Power Supply/VREG6V_SS: C4.2, IC1.2 (SS)
/Power Supply/VREG6V_SW: D1.2 (A), IC1.7 (SW), IC1.8 (SW), L1.2
/Power Supply/VREG6V_SWD: C9.1, C12.1, C13.1, D1.1 (K), L5.1, R2.2, R4.2
/Power Supply/VREGINT_SW: IC2.7 (SW), L2.1
GND: C1.2, C2.2, C3.2, C4.1, C5.1, C6.1, C7.2, C8.2, C10.2, C11.2, C12.2, C13.2, C14.2, C15.2, C16.2, C17.2, C18.1, C19.1, C20.1, C21.1, C22.1, C23.1, C24.1, C25.1, C26.1, C27.1, C28.1, IC1.4 (AGND), IC1.5 (PGND), IC1.6 (PGND), IC1.13 (PGND), IC2.3 (PGND), IC2.5 (SGND), IC2.6 (PGND), IC2.17 (SGND), IC3.1 (GND), IC3.7 (GND), IC4.1 (GND), IC4.7 (GND), IC5.1 (GND), IC5.7 (GND), IC6.1 (GND), IC6.7 (GND), J1.2, R3.1, R5.1, TP4.1, TP6.1, TP8.1, TP10.1, TP12.1; also elsewhere on the board
I2C_SCL: IC2.11 (SCL); also elsewhere on the board
I2C_SDA: IC2.10 (SDA); also elsewhere on the board
unnamed: C5.2, R1.1
USB_POWER: Q1.3 (D); also elsewhere on the board
VCCINT: C7.1, C10.1, IC2.9 (FB), L2.2, TP1.1; also elsewhere on the board
VREG6V_EN: IC1.11 (EN); also elsewhere on the board

Notes on the sheet:
Port 2 Mixers, up to 200mA
Source and 1.LO, up to 350mA
I2C address: 0x42
Port 1 Mixers, up to 200mA
Reference Mixers, up to 200mA

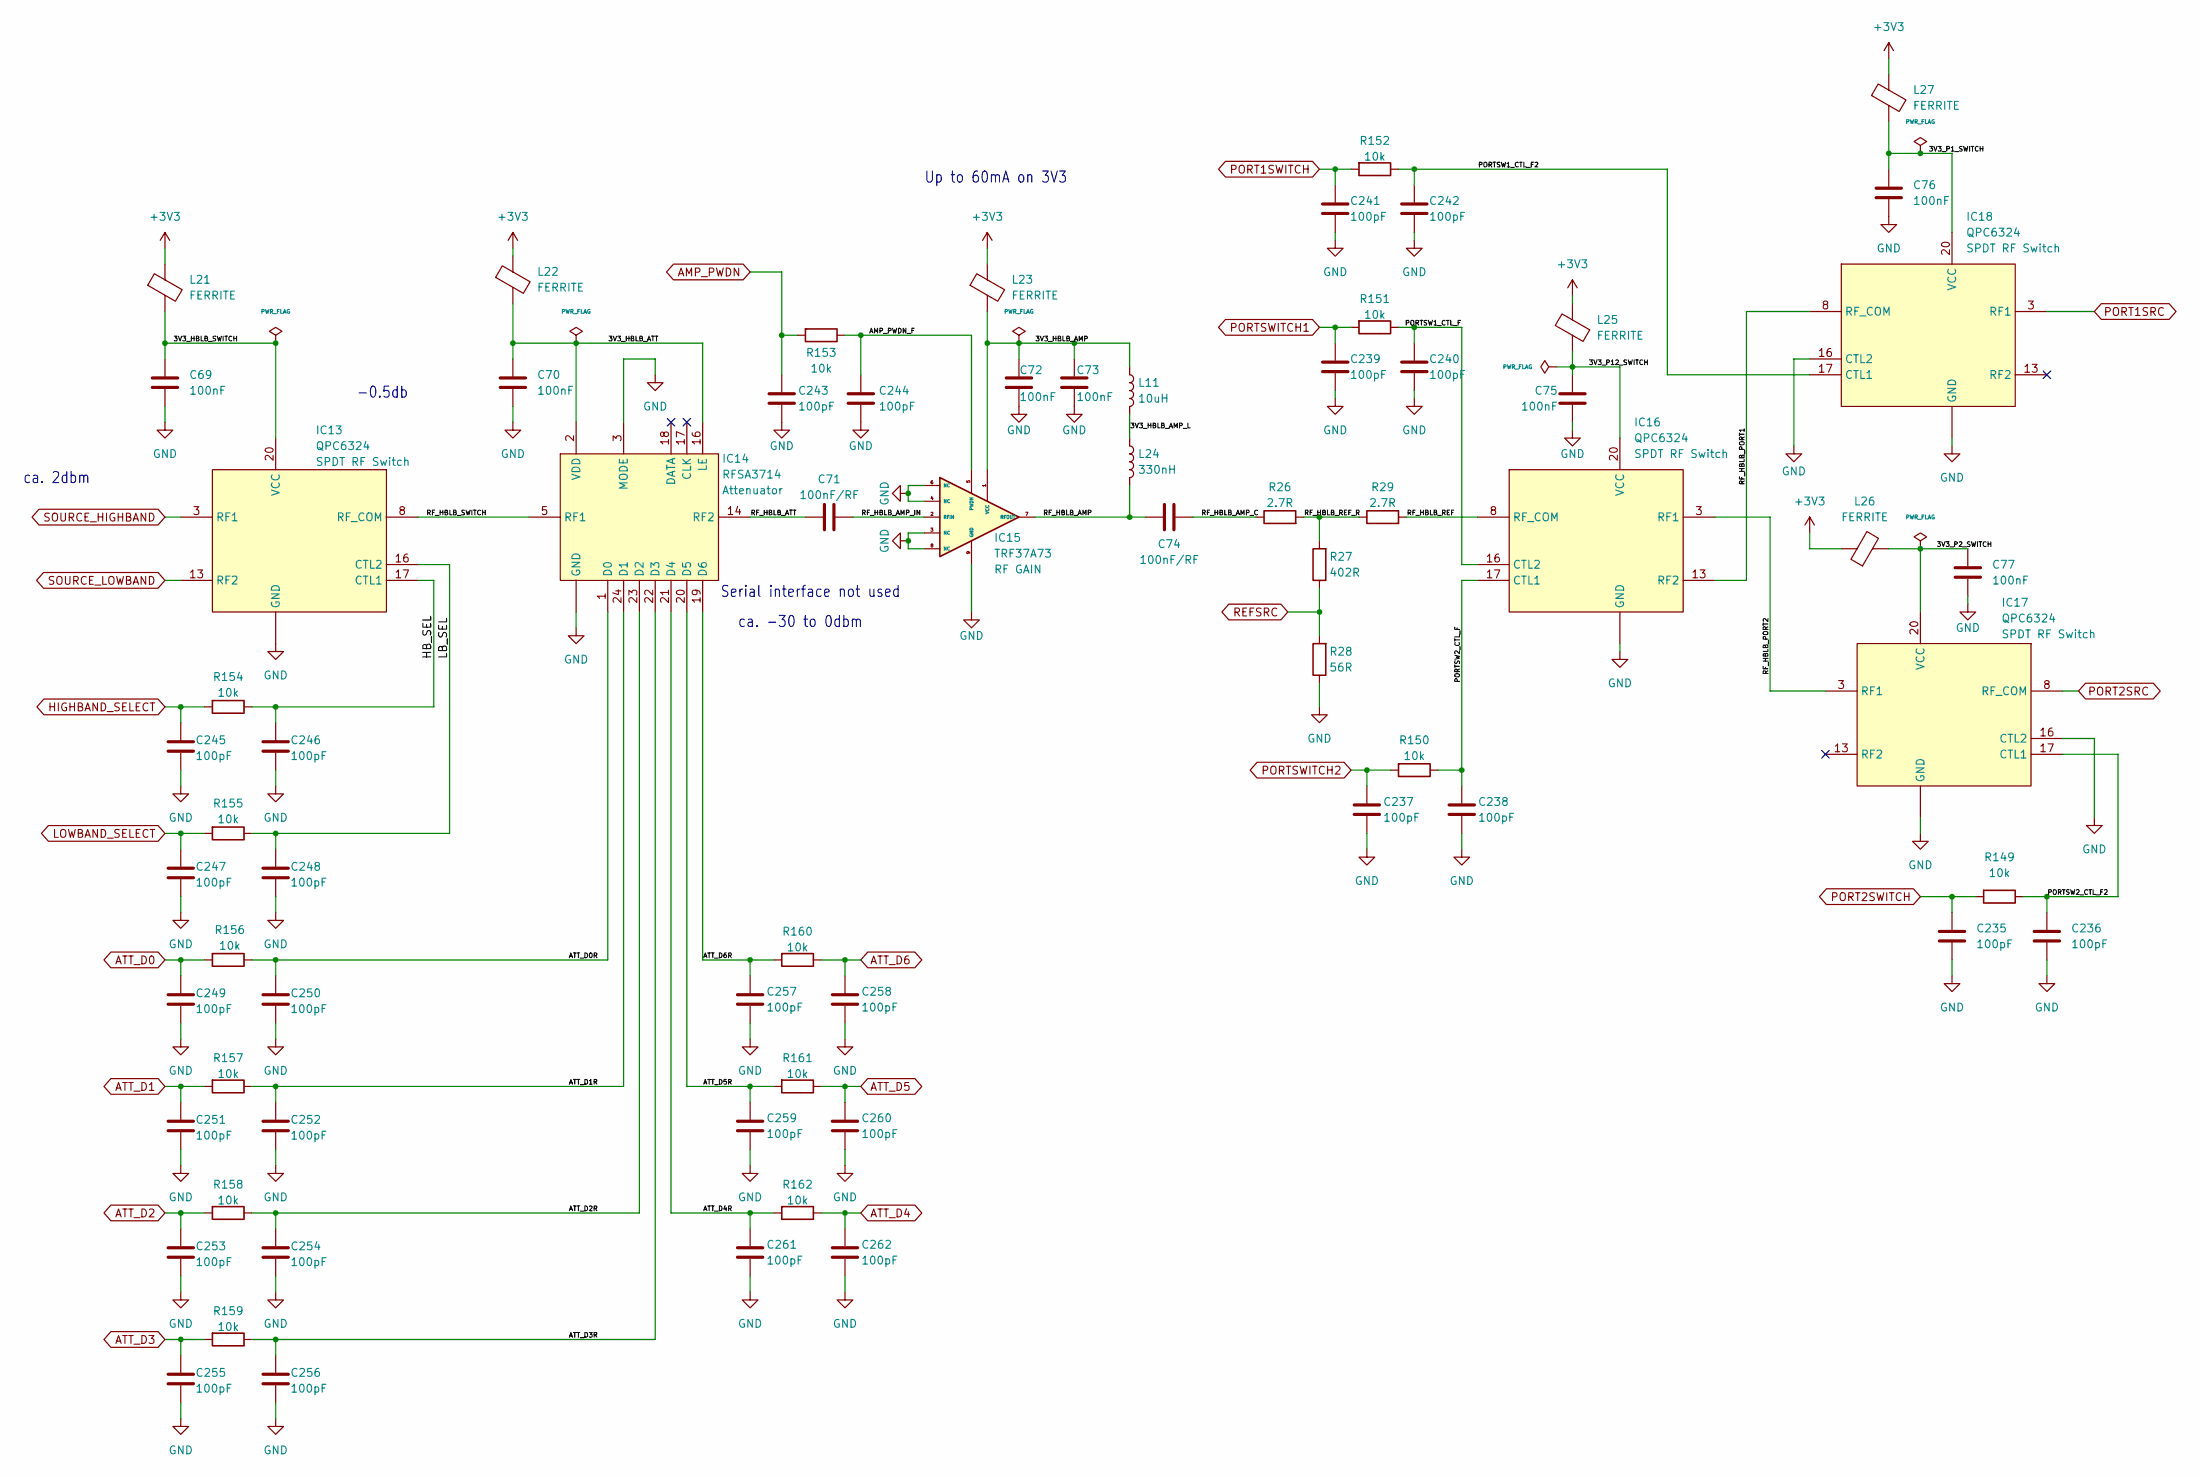
[picture p10: schematic AttenuatorSwitches.kicad_sch, Attenuator/Amplifier/Switches]

Parts:
C69, C70, C72, C73, C75, C76, C77: 100nF; C_0402_1005Metric
C71, C74: 100nF/RF; C_0402_1005Metric
C235, C236, C237, C238, C239, C240, C241, C242, C243, C244, C245, C246, C247, C248, C249, C250, C251, C252, C253, C254, C255, C256, C257, C258, C259, C260, C261, C262: 100pF; C_0402_1005Metric
IC13, IC16, IC17, IC18: QPC6324; QFN-20-1EP_4x4mm_P0.5mm_EP2.5x2.5mm; MPN QPC6324SR
IC14: RFSA3714; QFN-24-1EP_4x4mm_P0.5mm_EP2.6x2.6mm; MPN RFSA3714TR13
IC15: TRF37A73; DFN-8-1EP_2x2mm_P0.5mm_EP0.9x1.6mm; MPN TRF37A73IDSGR
L11: 10uH; L_0805_2012Metric_Pad1.15x1.40mm_HandSolder
L21, L22, L23, L25, L26, L27: FERRITE; R_0402_1005Metric; MPN BLM15AX601SN1
L24: 330nH; L_0402_1005Metric; MPN LQW15CNR33J10D
R26, R29: 2.7R; R_0402_1005Metric
R27: 402R; R_0402_1005Metric
R28: 56R; R_0402_1005Metric
R149, R150, R151, R152, R153, R154, R155, R156, R157, R158, R159, R160, R161, R162: 10k; R_0402_1005Metric

Connections:
+3V3: L21.1, L22.1, L23.1, L25.2, L26.1, L27.1; also elsewhere on the board
/Attenuator Amp Switches/3V3_HBLB_AMP: C72.1, C73.1, IC15.1 (VCC), L11.1, L23.2
/Attenuator Amp Switches/3V3_HBLB_AMP_L: L11.2, L24.1
/Attenuator Amp Switches/3V3_HBLB_ATT: C70.1, IC14.2 (VDD), IC14.16 (LE), L22.2
/Attenuator Amp Switches/3V3_HBLB_SWITCH: C69.1, IC13.20 (VCC), L21.2
/Attenuator Amp Switches/3V3_P1_SWITCH: C76.1, IC18.20 (VCC), L27.2
/Attenuator Amp Switches/3V3_P2_SWITCH: C77.1, IC17.20 (VCC), L26.2
/Attenuator Amp Switches/3V3_P12_SWITCH: C75.1, IC16.20 (VCC), L25.1
/Attenuator Amp Switches/AMP_PWDN_F: C244.1, IC15.5 (PWDN), R153.1
/Attenuator Amp Switches/ATT_D0R: C250.1, IC14.1 (D0), R156.1
/Attenuator Amp Switches/ATT_D1R: C252.1, IC14.24 (D1), R157.1
/Attenuator Amp Switches/ATT_D2R: C254.1, IC14.23 (D2), R158.1
/Attenuator Amp Switches/ATT_D3R: C256.1, IC14.22 (D3), R159.1
/Attenuator Amp Switches/ATT_D4R: C261.1, IC14.21 (D4), R162.2
/Attenuator Amp Switches/ATT_D5R: C259.1, IC14.20 (D5), R161.2
/Attenuator Amp Switches/ATT_D6R: C257.1, IC14.19 (D6), R160.2
/Attenuator Amp Switches/HB_SEL: C246.1, IC13.17 (CTL1), R154.1
/Attenuator Amp Switches/LB_SEL: C248.1, IC13.16 (CTL2), R155.1
/Attenuator Amp Switches/PORTSW1_CTL_F: C240.1, IC16.16 (CTL2), R151.1
/Attenuator Amp Switches/PORTSW1_CTL_F2: C242.1, IC18.17 (CTL1), R152.1
/Attenuator Amp Switches/PORTSW2_CTL_F: C238.1, IC16.17 (CTL1), R150.1
/Attenuator Amp Switches/PORTSW2_CTL_F2: C236.1, IC17.17 (CTL1), R149.1
/Attenuator Amp Switches/RF_HBLB_AMP: C74.1, IC15.7 (RFOUT), L24.2
/Attenuator Amp Switches/RF_HBLB_AMP_C: C74.2, R26.1
/Attenuator Amp Switches/RF_HBLB_AMP_IN: C71.2, IC15.2 (RFIN)
/Attenuator Amp Switches/RF_HBLB_ATT: C71.1, IC14.14 (RF2)
/Attenuator Amp Switches/RF_HBLB_PORT1: IC16.13 (RF2), IC18.8 (RF_COM)
/Attenuator Amp Switches/RF_HBLB_PORT2: IC16.3 (RF1), IC17.3 (RF1)
/Attenuator Amp Switches/RF_HBLB_REF: IC16.8 (RF_COM), R29.2
/Attenuator Amp Switches/RF_HBLB_REF_R: R26.2, R27.2, R29.1
/Attenuator Amp Switches/RF_HBLB_SWITCH: IC13.8 (RF_COM), IC14.5 (RF1)
AMP_PWDN: C243.1, R153.2; also elsewhere on the board
ATT_D0: C249.1, R156.2; also elsewhere on the board
ATT_D1: C251.1, R157.2; also elsewhere on the board
ATT_D2: C253.1, R158.2; also elsewhere on the board
ATT_D3: C255.1, R159.2; also elsewhere on the board
ATT_D4: C262.1, R162.1; also elsewhere on the board
ATT_D5: C260.1, R161.1; also elsewhere on the board
ATT_D6: C258.1, R160.1; also elsewhere on the board
GND: C69.2, C70.2, C72.2, C73.2, C75.2, C76.2, C77.2, C235.2, C236.2, C237.2, C238.2, C239.2, C240.2, C241.2, C242.2, C243.2, C244.2, C245.2, C246.2, C247.2, C248.2, C249.2, C250.2, C251.2, C252.2, C253.2, C254.2, C255.2, C256.2, C257.2, C258.2, C259.2, C260.2, C261.2, C262.2, IC13.1 (GND), IC13.2 (GND), IC13.4 (GND), IC13.5 (GND), IC13.6 (GND), IC13.7 (GND), IC13.9 (GND), IC13.10 (GND), IC13.11 (GND), IC13.12 (GND), IC13.14 (GND), IC13.15 (GND), IC13.18 (GND), IC13.19 (GND), IC13.21 (GND), IC14.3 (MODE), IC14.4 (GND), IC14.6 (GND), IC14.7 (GND), IC14.8 (GND), IC14.9 (GND), IC14.10 (GND), IC14.11 (GND), IC14.12 (GND), IC14.13 (GND), IC14.15 (GND), IC14.25 (GND), IC15.3 (NC), IC15.4 (NC), IC15.6 (NC), IC15.8 (NC), IC15.9 (GND), IC16.1 (GND), IC16.2 (GND), IC16.4 (GND), IC16.5 (GND), IC16.6 (GND), IC16.7 (GND), IC16.9 (GND), IC16.10 (GND), IC16.11 (GND), IC16.12 (GND), IC16.14 (GND), IC16.15 (GND), IC16.18 (GND), IC16.19 (GND), IC16.21 (GND), IC17.1 (GND), IC17.2 (GND), IC17.4 (GND), IC17.5 (GND), IC17.6 (GND), IC17.7 (GND), IC17.9 (GND), IC17.10 (GND), IC17.11 (GND), IC17.12 (GND), IC17.14 (GND), IC17.15 (GND), IC17.16 (CTL2), IC17.18 (GND), IC17.19 (GND), IC17.21 (GND), IC18.1 (GND), IC18.2 (GND), IC18.4 (GND), IC18.5 (GND), IC18.6 (GND), IC18.7 (GND), IC18.9 (GND), IC18.10 (GND), IC18.11 (GND), IC18.12 (GND), IC18.14 (GND), IC18.15 (GND), IC18.16 (CTL2), IC18.18 (GND), IC18.19 (GND), IC18.21 (GND), R28.1; also elsewhere on the board
HIGHBAND_SELECT: C245.1, R154.2; also elsewhere on the board
LOWBAND_SELECT: C247.1, R155.2; also elsewhere on the board
PORT1SRC: IC18.3 (RF1); also elsewhere on the board
PORT1SWITCH: C241.1, R152.2; also elsewhere on the board
PORT2SRC: IC17.8 (RF_COM); also elsewhere on the board
PORT2SWITCH: C235.1, R149.2; also elsewhere on the board
PORTSWITCH1: C239.1, R151.2; also elsewhere on the board
PORTSWITCH2: C237.1, R150.2; also elsewhere on the board
REFSRC: R27.1, R28.2; also elsewhere on the board
SOURCE_HIGHBAND: IC13.3 (RF1); also elsewhere on the board
SOURCE_LOWBAND: IC13.13 (RF2); also elsewhere on the board

Notes on the sheet:
ca. 2dbm
-0.5db
Up to 60mA on 3V3
ca. -30 to 0dbm
Serial interface not used

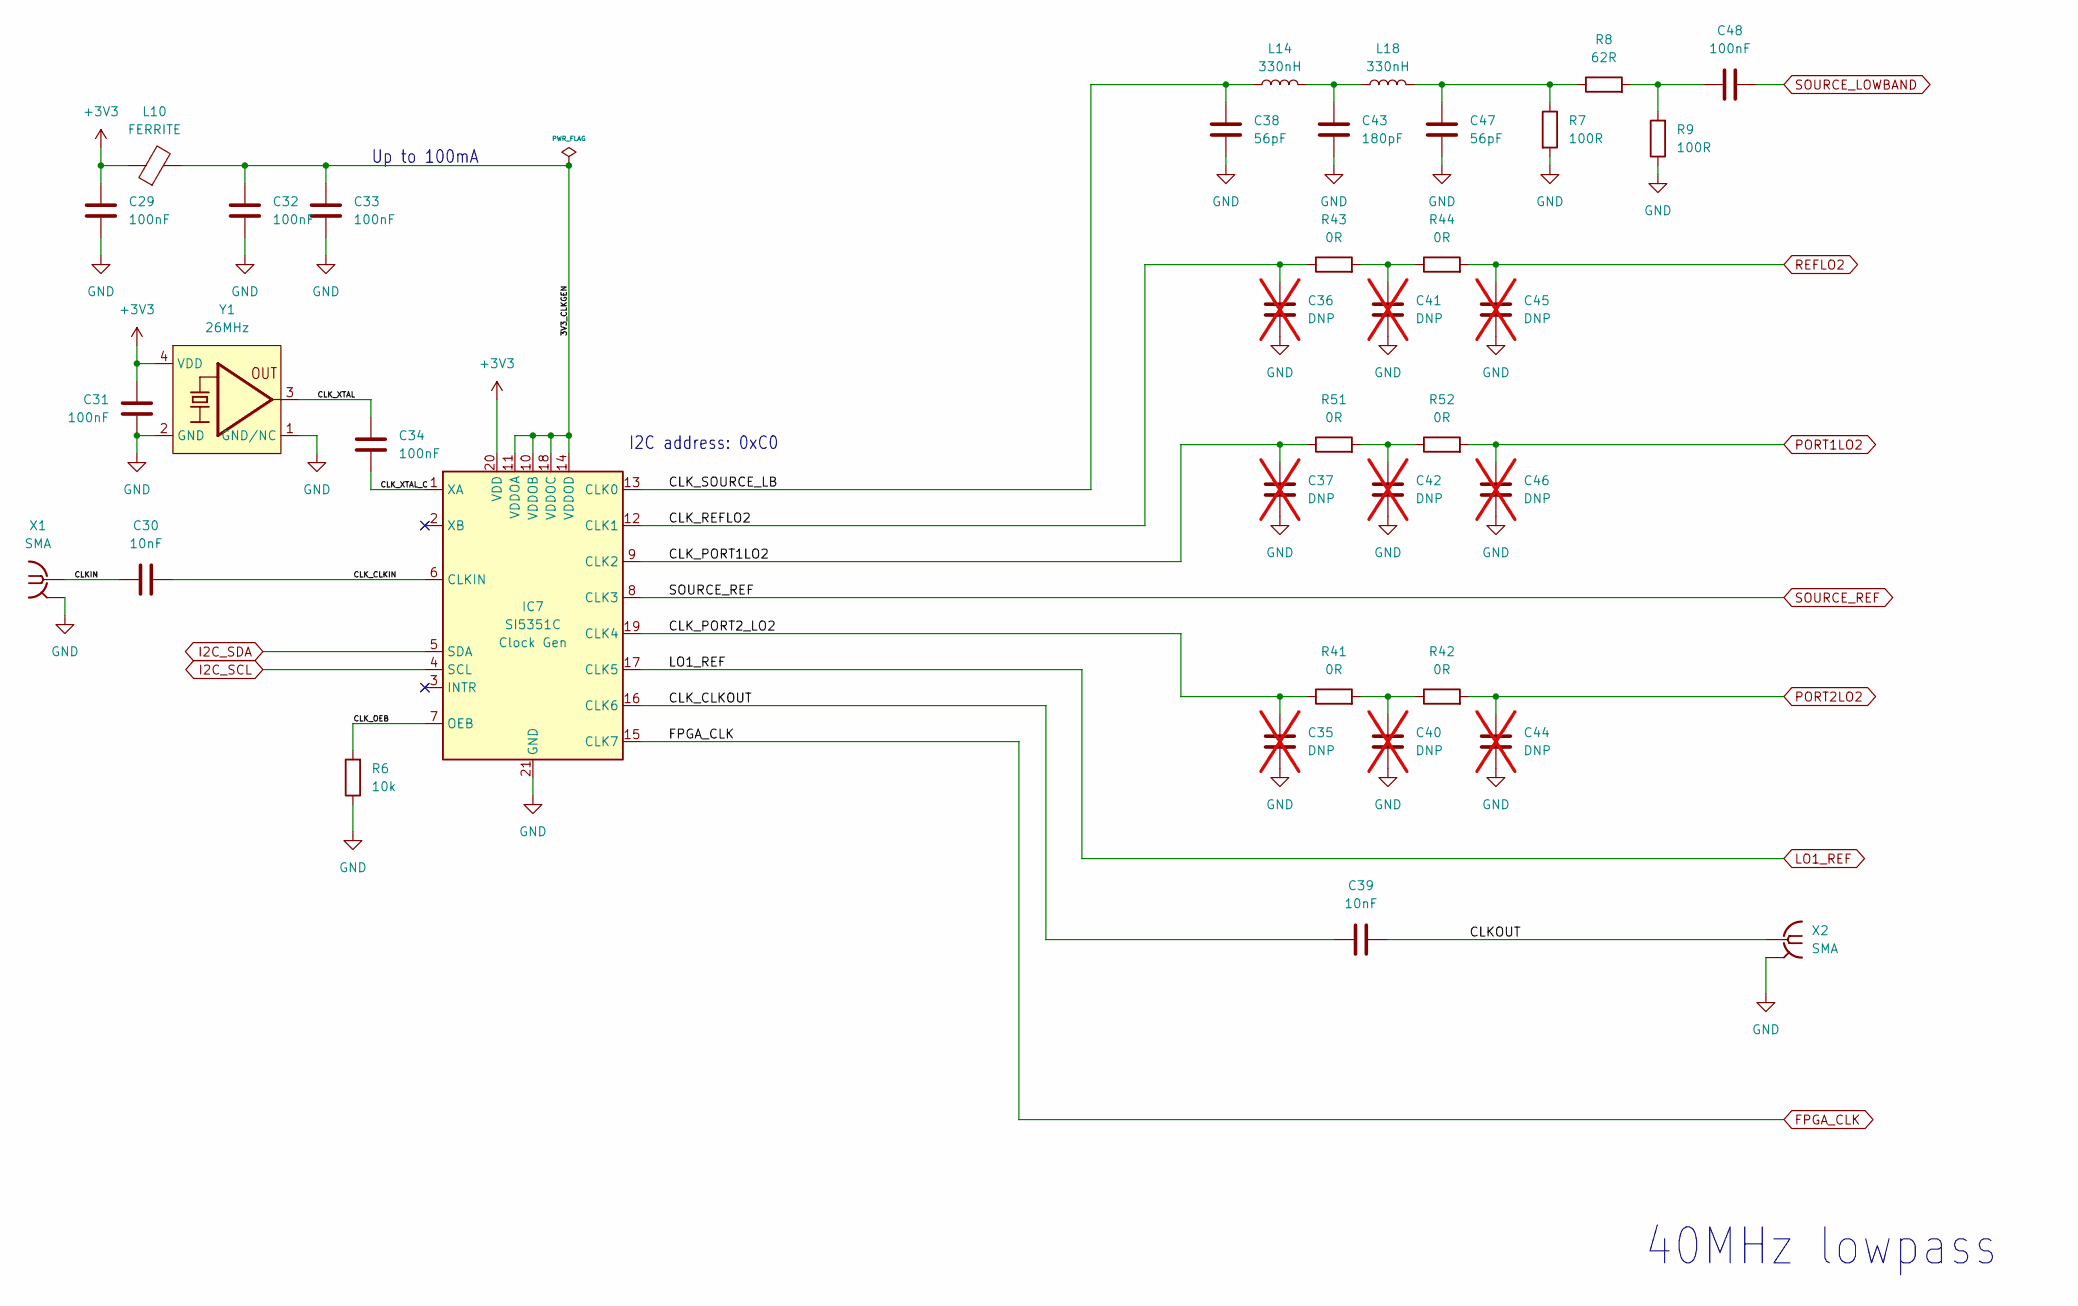
[picture p11: schematic LocalOsc2_RefClock.kicad_sch, Reference Clock and 2.LO]

Parts:
C29, C31, C32, C33, C34, C48: 100nF; C_0402_1005Metric
C30, C39: 10nF; C_0402_1005Metric
C35, C36, C37, C40, C41, C42, C44, C45, C46: DNP; C_0402_1005Metric; not fitted
C38, C47: 56pF; C_0402_1005Metric
C43: 180pF; C_0402_1005Metric
IC7: SI5351C; QFN-20-1EP_4x4mm_P0.5mm_EP2.7x2.7mm; MPN SI5351C-B-GM
L10: FERRITE; R_0402_1005Metric; MPN BLM15AX601SN1
L14, L18: 330nH; L_0402_1005Metric; MPN LQW15CNR33J10D
R6: 10k; R_0402_1005Metric
R7, R9: 100R; R_0402_1005Metric
R8: 62R; R_0402_1005Metric
R41, R42, R43, R44, R51, R52: 0R; R_0402_1005Metric
X1, X2: SMA; J502-ND-142-0711-821_826
Y1: 26MHz; Oscillator_SMD_ECS_20CSMV4_2.0x1.6mm; MPN ECS-TXO-20CSMV4-260-AN-TR

Connections:
+3V3: C29.2, C31.2, IC7.20 (VDD), L10.1, Y1.4 (VDD); also elsewhere on the board
/2.LO + Ref Clock/3V3_CLKGEN: C32.2, C33.2, IC7.10 (VDDOB), IC7.11 (VDDOA), IC7.14 (VDDOD), IC7.18 (VDDOC), L10.2
/2.LO + Ref Clock/CLKIN: C30.1, X1.1
/2.LO + Ref Clock/CLKOUT: C39.2, X2.1
/2.LO + Ref Clock/CLK_CLKIN: C30.2, IC7.6 (CLKIN)
/2.LO + Ref Clock/CLK_CLKOUT: C39.1, IC7.16 (CLK6)
/2.LO + Ref Clock/CLK_OEB: IC7.7 (OEB), R6.2
/2.LO + Ref Clock/CLK_PORT1LO2: C37.1, IC7.9 (CLK2), R51.1
/2.LO + Ref Clock/CLK_PORT2_LO2: C35.1, IC7.19 (CLK4), R41.1
/2.LO + Ref Clock/CLK_REFLO2: C36.1, IC7.12 (CLK1), R43.1
/2.LO + Ref Clock/CLK_SOURCE_LB: C38.1, IC7.13 (CLK0), L14.1
/2.LO + Ref Clock/CLK_XTAL: C34.2, Y1.3 (OUT)
/2.LO + Ref Clock/CLK_XTAL_C: C34.1, IC7.1 (XA)
FPGA_CLK: IC7.15 (CLK7); also elsewhere on the board
GND: C29.1, C31.1, C32.1, C33.1, C35.2, C36.2, C37.2, C38.2, C40.2, C41.2, C42.2, C43.2, C44.2, C45.2, C46.2, C47.2, IC7.21 (GND), R6.1, R7.2, R9.1, X1.G@1 (2), X1.G@2 (2), X1.G@3 (2), X1.G@4 (2), X2.G@1 (2), X2.G@2 (2), X2.G@3 (2), X2.G@4 (2), Y1.1 (GND/NC), Y1.2 (GND); also elsewhere on the board
I2C_SCL: IC7.4 (SCL); also elsewhere on the board
I2C_SDA: IC7.5 (SDA); also elsewhere on the board
LO1_REF: IC7.17 (CLK5); also elsewhere on the board
unnamed: C40.1, R41.2, R42.1
unnamed: C41.1, R43.2, R44.1
unnamed: C42.1, R51.2, R52.1
unnamed: C43.1, L14.2, L18.1
unnamed: C47.1, L18.2, R7.1, R8.1
unnamed: C48.2, R8.2, R9.2
PORT1LO2: C46.1, R52.2; also elsewhere on the board
PORT2LO2: C44.1, R42.2; also elsewhere on the board
REFLO2: C45.1, R44.2; also elsewhere on the board
SOURCE_LOWBAND: C48.1; also elsewhere on the board
SOURCE_REF: IC7.8 (CLK3); also elsewhere on the board

Notes on the sheet:
I2C address: 0xC0
40MHz lowpass
Up to 100mA

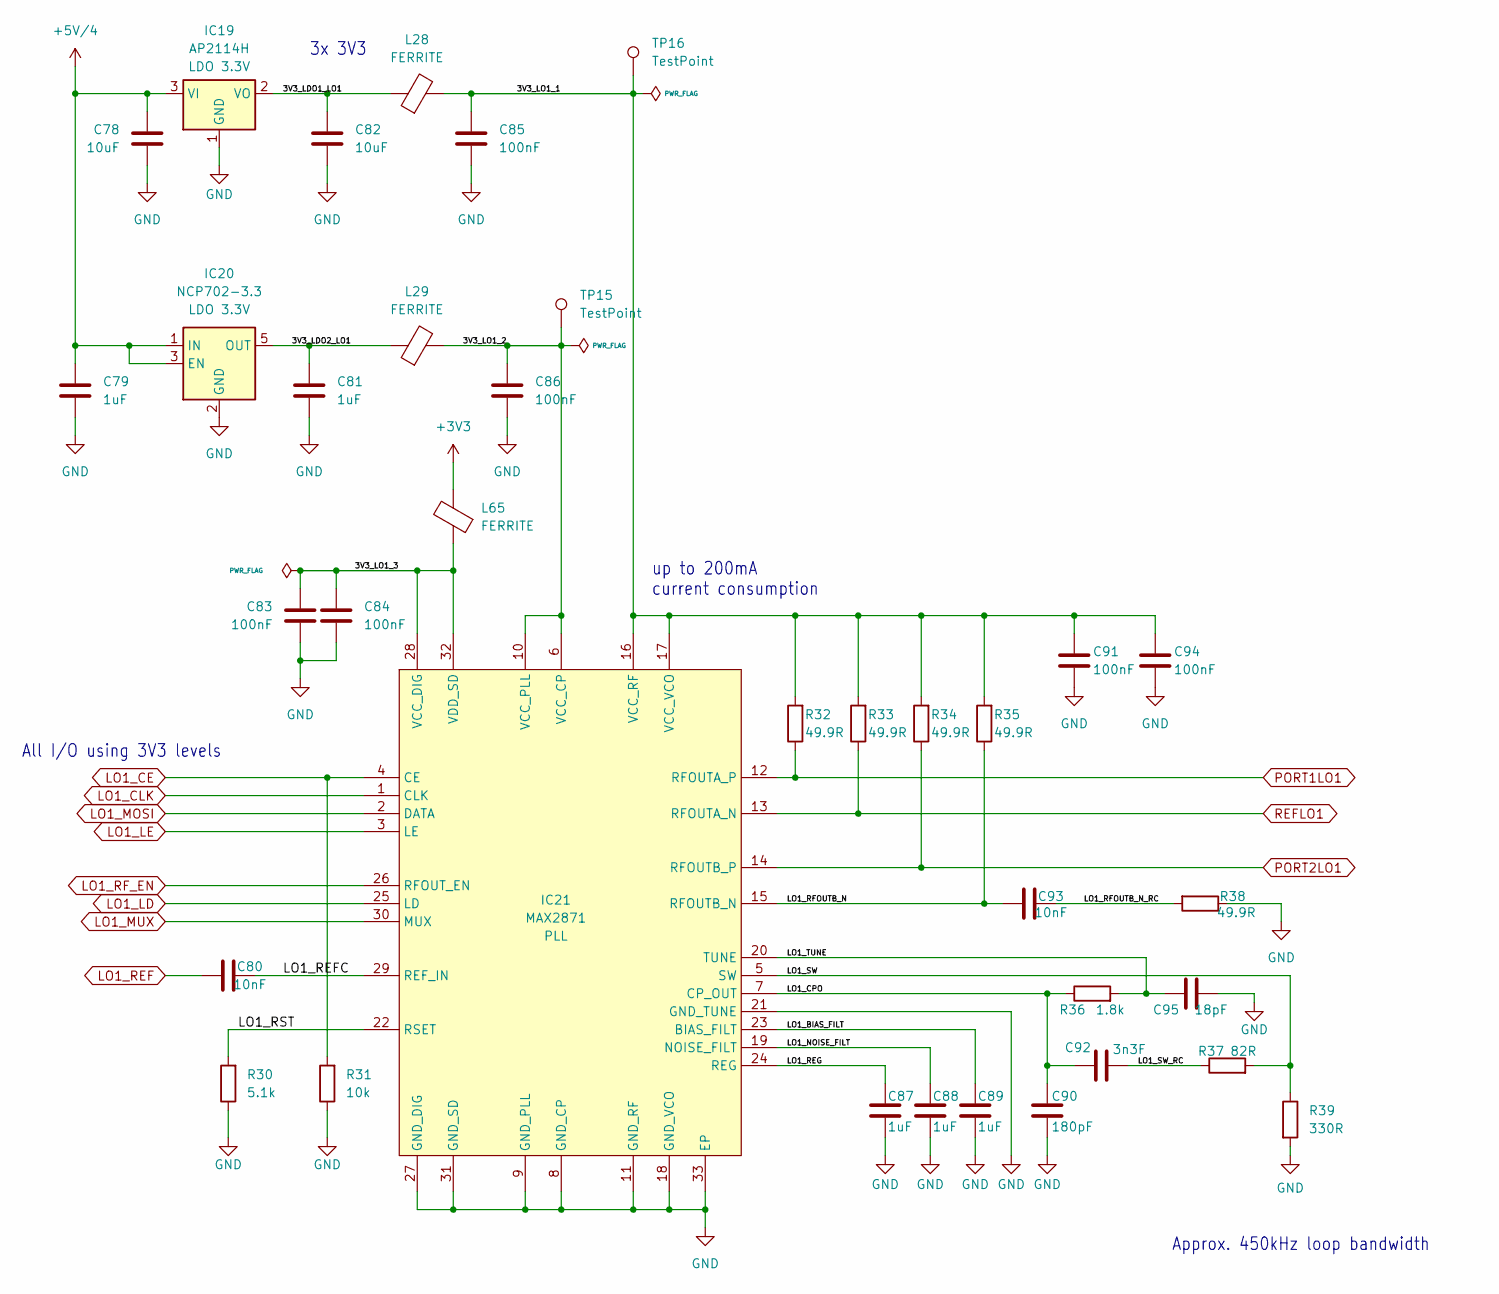
[picture p12: schematic LocalOsc1.kicad_sch, 1.LO]

Parts:
C78, C82: 10uF; C_1206_3216Metric
C79, C81: 1uF; C_0603_1608Metric
C80, C93: 10nF; C_0402_1005Metric
C83, C84, C85, C86, C91, C94: 100nF; C_0402_1005Metric
C87, C88, C89: 1uF; C_0402_1005Metric
C90: 180pF; C_0402_1005Metric
C92: 3n3F; C_0402_1005Metric
C95: 18pF; C_0402_1005Metric
IC19: AP2114H; SOT-223-3_TabPin2; MPN AP2114H-3.3TRG1
IC20: NCP702-3.3; SOT-23-5; MPN NCP702SN33T1G
IC21: MAX2871; QFN-32-1EP_5x5mm_P0.5mm_EP3.1x3.1mm; MPN MAX2871ETJ+
L28, L29, L65: FERRITE; R_0402_1005Metric; MPN BLM15AX601SN1
R30: 5.1k; R_0402_1005Metric
R31: 10k; R_0402_1005Metric
R32, R33, R34, R35, R38: 49.9R; R_0402_1005Metric
R36: 1.8k; R_0402_1005Metric
R37: 82R; R_0402_1005Metric
R39: 330R; R_0402_1005Metric
TP15, TP16: TestPoint; B1,27

Connections:
+3V3: L65.2; also elsewhere on the board
+5V/4: C78.1, C79.1, IC19.3 (VI), IC20.1 (IN), IC20.3 (EN); also elsewhere on the board
/1.LO/3V3_LDO1_LO1: C82.1, IC19.2 (VO), L28.1
/1.LO/3V3_LDO2_LO1: C81.1, IC20.5 (OUT), L29.1
/1.LO/3V3_LO1_1: C85.1, C91.1, C94.1, IC21.16 (VCC_RF), IC21.17 (VCC_VCO), L28.2, R32.2, R33.2, R34.2, R35.2, TP16.1
/1.LO/3V3_LO1_2: C86.1, IC21.6 (VCC_CP), IC21.10 (VCC_PLL), L29.2, TP15.1
/1.LO/3V3_LO1_3: C83.1, C84.1, IC21.28 (VCC_DIG), IC21.32 (VDD_SD), L65.1
/1.LO/LO1_BIAS_FILT: C89.1, IC21.23 (BIAS_FILT)
/1.LO/LO1_CPO: C90.1, C92.2, IC21.7 (CP_OUT), R36.1
/1.LO/LO1_NOISE_FILT: C88.1, IC21.19 (NOISE_FILT)
/1.LO/LO1_REFC: C80.2, IC21.29 (REF_IN)
/1.LO/LO1_REG: C87.1, IC21.24 (REG)
/1.LO/LO1_RFOUTB_N: C93.2, IC21.15 (RFOUTB_N), R35.1
/1.LO/LO1_RFOUTB_N_RC: C93.1, R38.2
/1.LO/LO1_RST: IC21.22 (RSET), R30.2
/1.LO/LO1_SW: IC21.5 (SW), R37.2, R39.1
/1.LO/LO1_SW_RC: C92.1, R37.1
/1.LO/LO1_TUNE: C95.2, IC21.20 (TUNE), R36.2
GND: C78.2, C79.2, C81.2, C82.2, C83.2, C84.2, C85.2, C86.2, C87.2, C88.2, C89.2, C90.2, C91.2, C94.2, C95.1, IC19.1 (GND), IC20.2 (GND), IC21.8 (GND_CP), IC21.9 (GND_PLL), IC21.11 (GND_RF), IC21.18 (GND_VCO), IC21.21 (GND_TUNE), IC21.27 (GND_DIG), IC21.31 (GND_SD), IC21.33 (EP), R30.1, R31.1, R38.1, R39.2; also elsewhere on the board
LO1_CE: IC21.4 (CE), R31.2; also elsewhere on the board
LO1_CLK: IC21.1 (CLK); also elsewhere on the board
LO1_LD: IC21.25 (LD); also elsewhere on the board
LO1_LE: IC21.3 (LE); also elsewhere on the board
LO1_MOSI: IC21.2 (DATA); also elsewhere on the board
LO1_MUX: IC21.30 (MUX); also elsewhere on the board
LO1_REF: C80.1; also elsewhere on the board
LO1_RF_EN: IC21.26 (RFOUT_EN); also elsewhere on the board
PORT1LO1: IC21.12 (RFOUTA_P), R32.1; also elsewhere on the board
PORT2LO1: IC21.14 (RFOUTB_P), R34.1; also elsewhere on the board
REFLO1: IC21.13 (RFOUTA_N), R33.1; also elsewhere on the board

Notes on the sheet:
All I/O using 3V3 levels
up to 200mA current consumption
3x 3V3
Approx. 450kHz loop bandwidth
