sophiekovalevsky/LibreVNA/pr-previews/2/3483b7b/VNA.kicad_pcb

## KiCad design pr-previews/2/3483b7b/VNA.kicad_pcb (continued)

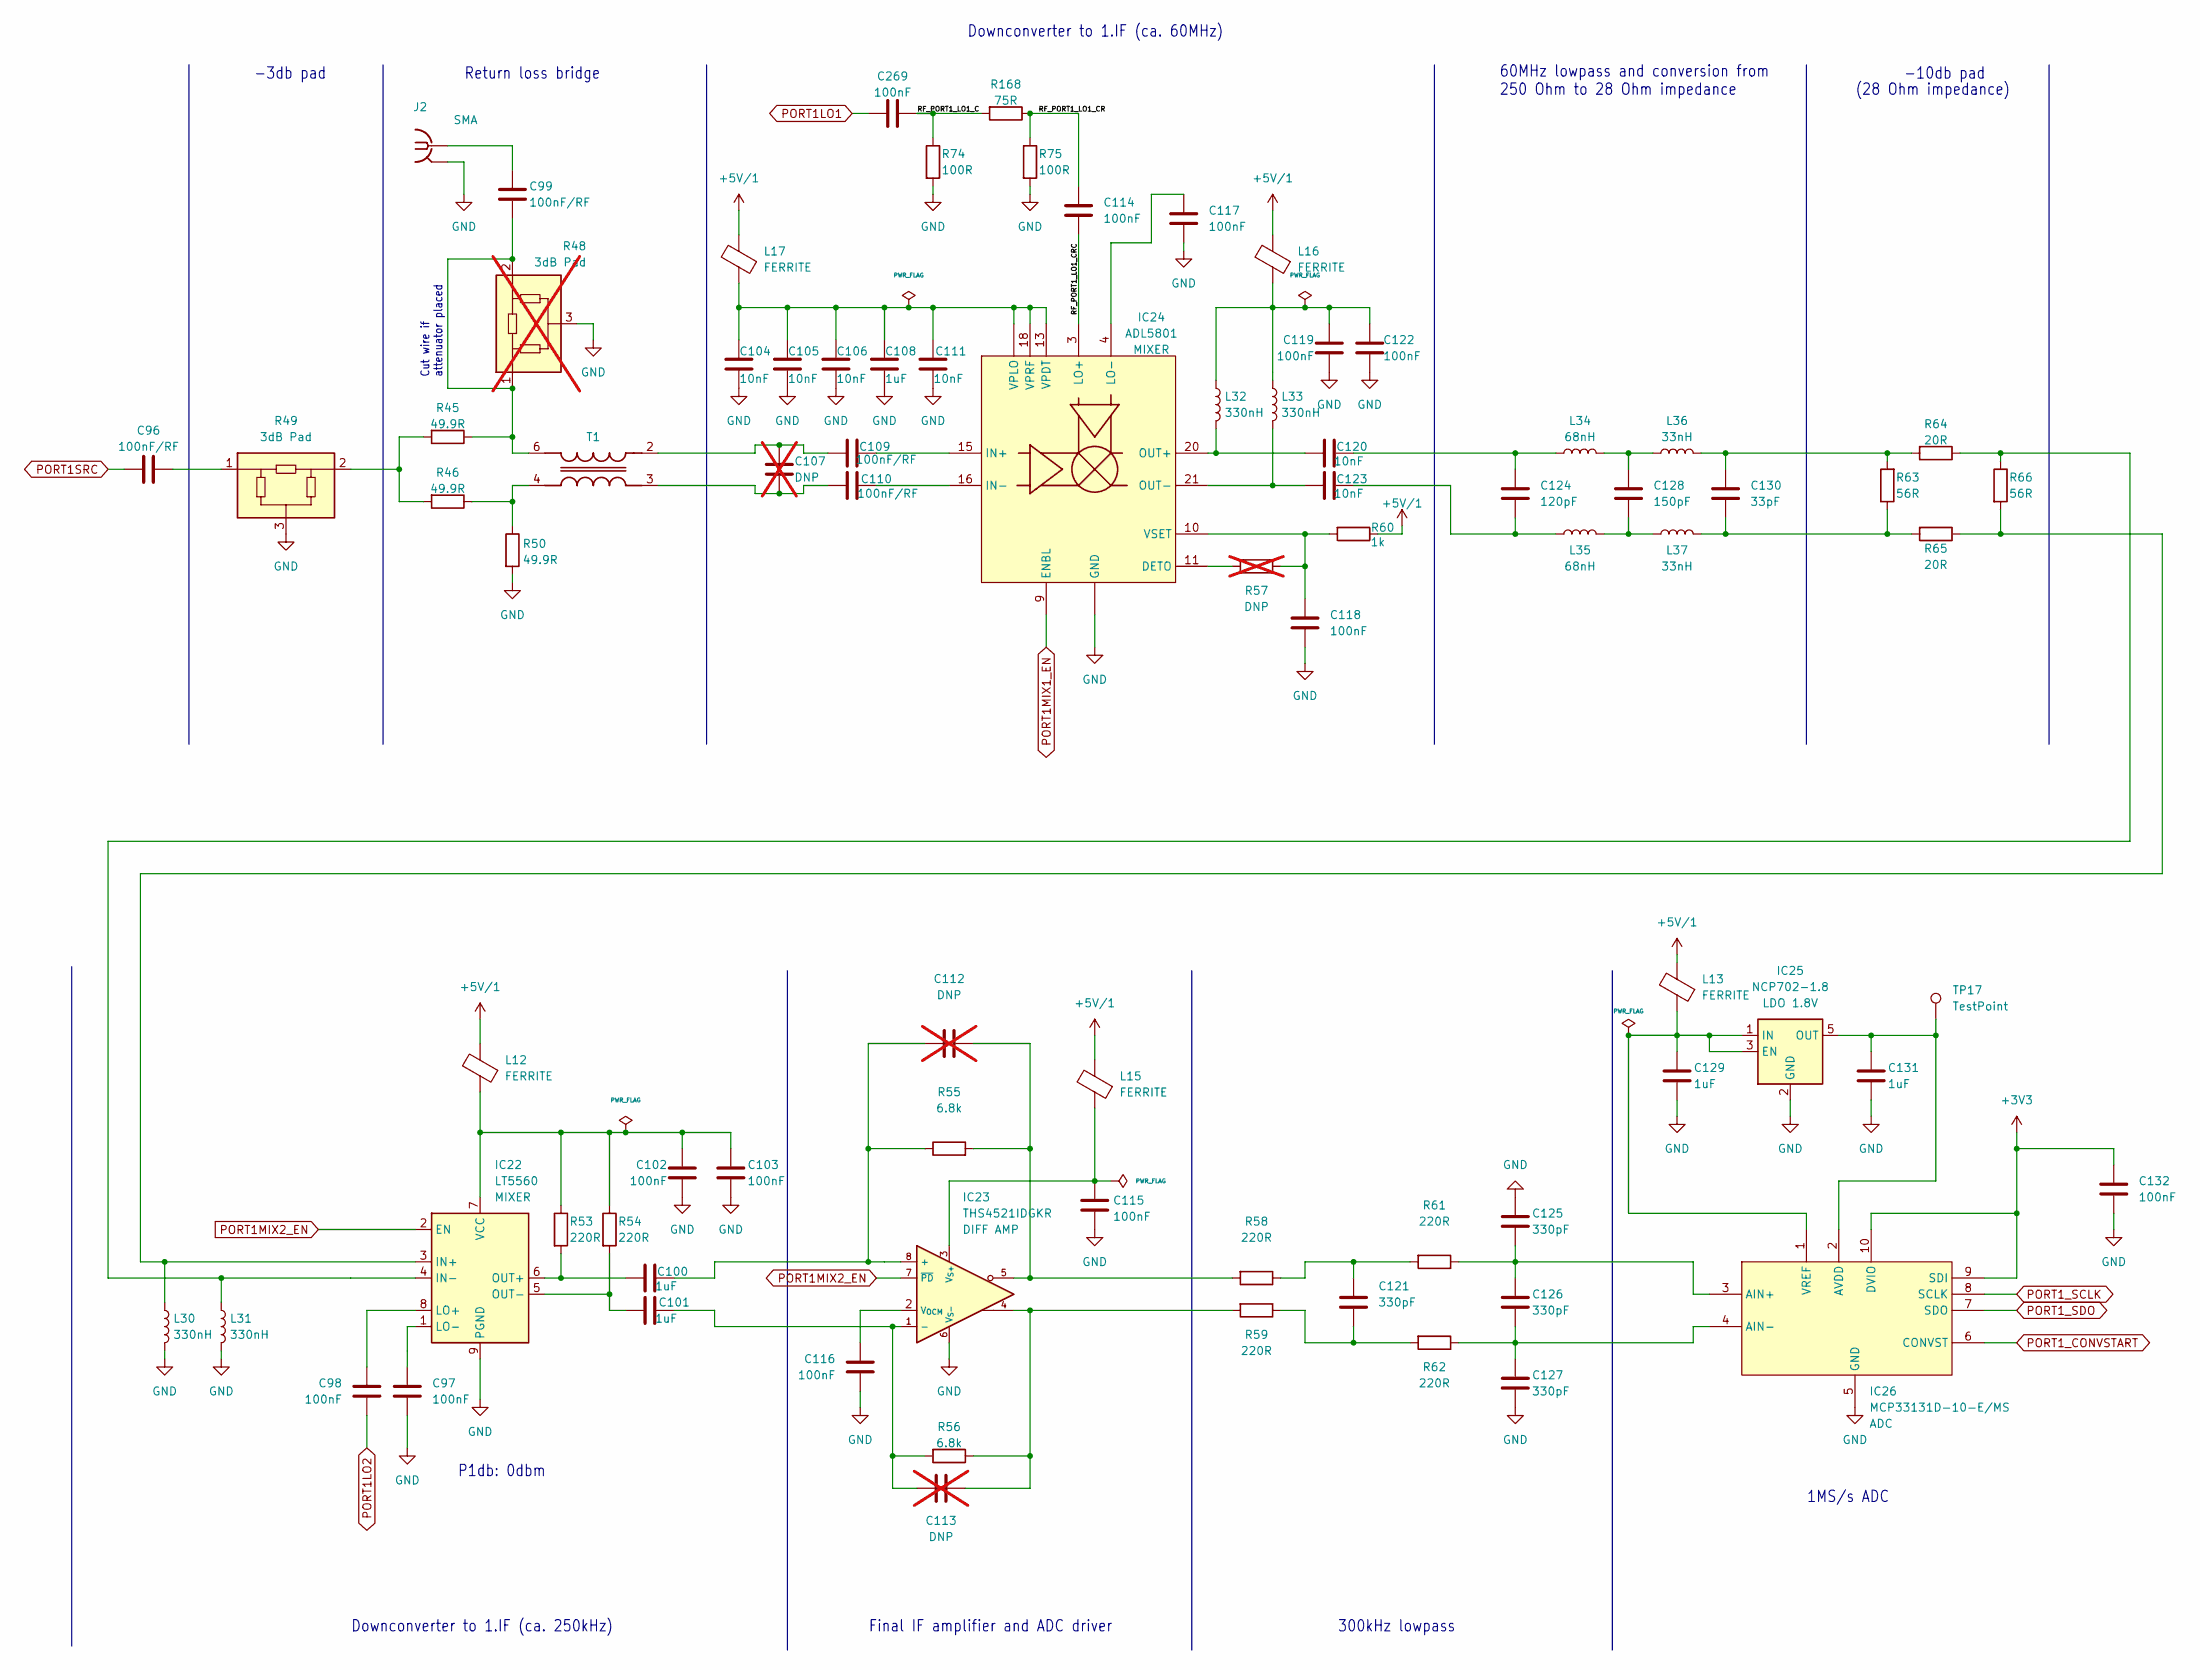
[picture p13: schematic Port1.kicad_sch, Port 1]

Parts:
C96, C99, C109, C110: 100nF/RF; C_0402_1005Metric
C97, C98, C102, C103, C114, C115, C116, C117, C118, C119, C122, C132, C269: 100nF; C_0402_1005Metric
C100, C101, C108, C129, C131: 1uF; C_0402_1005Metric
C104, C105, C106, C111, C120, C123: 10nF; C_0402_1005Metric
C107, C112, C113: DNP; C_0402_1005Metric; not fitted
C121, C125, C126, C127: 330pF; C_0402_1005Metric
C124: 120pF; C_0402_1005Metric
C128: 150pF; C_0402_1005Metric
C130: 33pF; C_0402_1005Metric
IC22: LT5560; WSON-8-1EP_3x3mm_P0.5mm_EP1.45x2.4mm; MPN LT5560EDD
IC23: THS4521IDGKR; VSSOP-8_3.0x3.0mm_P0.65mm; MPN THS4521IDGKR
IC24: ADL5801; QFN-24-1EP_4x4mm_P0.5mm_EP2.6x2.6mm; MPN ADL5801
IC25: NCP702-1.8; SOT-23-5; MPN NCP702SN18T1G
IC26: MCP33131D-10-E/MS; VSSOP-10_3x3mm_P0.5mm; MPN MCP33131D-10-E/MS
J2: SMA; BU-1420701851; MPN AMPHENOL-132289
L12, L13, L15, L16, L17: FERRITE; R_0402_1005Metric; MPN BLM15AX601SN1
L30, L31, L32, L33: 330nH; L_0402_1005Metric; MPN LQW15CNR33J10D
L34, L35: 68nH; L_0402_1005Metric; MPN LQW15AN68NJ00D
L36, L37: 33nH; L_0402_1005Metric; MPN LQW15AN33NJ00D
R45, R46, R50: 49.9R; R_0402_1005Metric
R48: PAT0816-C-3DB-T5; PAT0816; not fitted
R49: PAT0816-C-3DB-T5; PAT0816
R53, R54, R58, R59, R61, R62: 220R; R_0402_1005Metric
R55, R56: 6.8k; R_0402_1005Metric
R57: DNP; R_0402_1005Metric; not fitted
R60: 1k; R_0402_1005Metric
R63, R66: 56R; R_0402_1005Metric
R64, R65: 20R; R_0402_1005Metric
R74, R75: 100R; R_0402_1005Metric
R168: 75R; R_0402_1005Metric
T1: B012-617DB-1-63-B331; EASTEVER_BALUN; MPN B012-617DB-1-63-B331
TP17: TestPoint; B1,27

Connections:
+3V3: C132.2, IC26.9 (SDI), IC26.10 (DVIO); also elsewhere on the board
+5V/1: L12.2, L13.2, L15.2, L16.2, L17.2, R60.1; also elsewhere on the board
/Port 1/RF_PORT1_LO1_C: C269.2, R74.1, R168.2
/Port 1/RF_PORT1_LO1_CR: C114.1, R75.1, R168.1
/Port 1/RF_PORT1_LO1_CRC: C114.2, IC24.3 (LO+)
GND: C97.1, C102.1, C103.1, C104.2, C105.2, C106.2, C108.2, C111.2, C115.1, C116.2, C117.2, C118.1, C119.2, C122.2, C125.1, C127.2, C129.2, C131.2, C132.1, IC22.9 (PGND), IC23.6 (V_{S-}), IC24.1 (GND), IC24.2 (GND), IC24.5 (GND), IC24.6 (GND), IC24.8 (GND), IC24.12 (GND), IC24.14 (GND), IC24.17 (GND), IC24.19 (GND), IC24.23 (GND), IC24.25 (GND), IC25.2 (GND), IC26.5 (GND), J2.G@1 (2), J2.G@2 (2), J2.G@3 (2), J2.G@4 (2), L30.2, L31.2, R48.3, R49.3, R50.2, R74.2, R75.2; also elsewhere on the board
unnamed: C96.2, R49.1
unnamed: C99.1, J2.1
unnamed: C112.2, IC23.5, R55.2, R58.2
unnamed: C113.1, IC23.4, R56.1, R59.2
unnamed: C119.1, C122.1, L16.1, L32.1, L33.1
unnamed: C120.2, C124.1, L34.1
unnamed: C121.1, R58.1, R61.2
unnamed: C121.2, R59.1, R62.2
unnamed: C123.2, C124.2, L35.1
unnamed: C128.1, L34.2, L36.1
unnamed: C128.2, L35.2, L37.1
unnamed: C130.1, L36.2, R63.2, R64.2
unnamed: C130.2, L37.2, R63.1, R65.2
unnamed: IC22.3 (IN+), L30.1, R65.1, R66.2
unnamed: IC22.4 (IN-), L31.1, R64.1, R66.1
unnamed: C98.2, IC22.8 (LO+)
unnamed: C97.2, IC22.1 (LO-)
unnamed: C100.1, IC22.6 (OUT+), R53.2
unnamed: C101.1, IC22.5 (OUT-), R54.2
unnamed: C102.2, C103.2, IC22.7 (VCC), L12.1, R53.1, R54.1
unnamed: C100.2, C112.1, IC23.8 (+), R55.1
unnamed: C101.2, C113.2, IC23.1 (-), R56.2
unnamed: C116.1, IC23.2 (V_{OCM})
unnamed: C115.2, IC23.3 (V_{S+}), L15.1
unnamed: IC24.11 (DETO), R57.2
unnamed: C109.2, IC24.15 (IN+)
unnamed: C110.2, IC24.16 (IN-)
unnamed: C117.1, IC24.4 (LO-)
unnamed: C120.1, IC24.20 (OUT+), L32.2
unnamed: C123.1, IC24.21 (OUT-), L33.2
unnamed: C104.1, C105.1, C106.1, C108.1, C111.1, IC24.7 (VPLO), IC24.13 (VPDT), IC24.18 (VPRF), IC24.24 (VPLO), L17.1
unnamed: C118.2, IC24.10 (VSET), R57.1, R60.2
unnamed: C129.1, IC25.1 (IN), IC25.3 (EN), IC26.1 (VREF), L13.1
unnamed: C131.1, IC25.5 (OUT), IC26.2 (AVDD), TP17.1
unnamed: C125.2, C126.1, IC26.3 (AIN+), R61.1
unnamed: C126.2, C127.1, IC26.4 (AIN-), R62.1
unnamed: R45.2, R46.2, R49.2
unnamed: C107.1, C110.1, T1.3 (IN+)
unnamed: C107.2, C109.1, T1.2 (IN-)
unnamed: R46.1, R50.1, T1.4 (OUT+)
unnamed: C99.2, R45.1, R48.1, R48.2, T1.6 (OUT-)
PORT1LO1: C269.1; also elsewhere on the board
PORT1LO2: C98.1; also elsewhere on the board
PORT1MIX1_EN: IC24.9 (ENBL); also elsewhere on the board
PORT1MIX2_EN: IC22.2 (EN), IC23.7 (~PD); also elsewhere on the board
PORT1SRC: C96.1; also elsewhere on the board
PORT1_CONVSTART: IC26.6 (CONVST); also elsewhere on the board
PORT1_SCLK: IC26.8 (SCLK); also elsewhere on the board
PORT1_SDO: IC26.7 (SDO); also elsewhere on the board

Notes on the sheet:
Downconverter to 1.IF (ca. 250kHz)
(28 Ohm impedance)
-3db pad
Cut wire if attenuator placed
Return loss bridge
Final IF amplifier and ADC driver
P1db: 0dbm
Downconverter to 1.IF (ca. 60MHz)
-10db pad
300kHz lowpass
60MHz lowpass and conversion from 250 Ohm to 28 Ohm impedance
1MS/s ADC

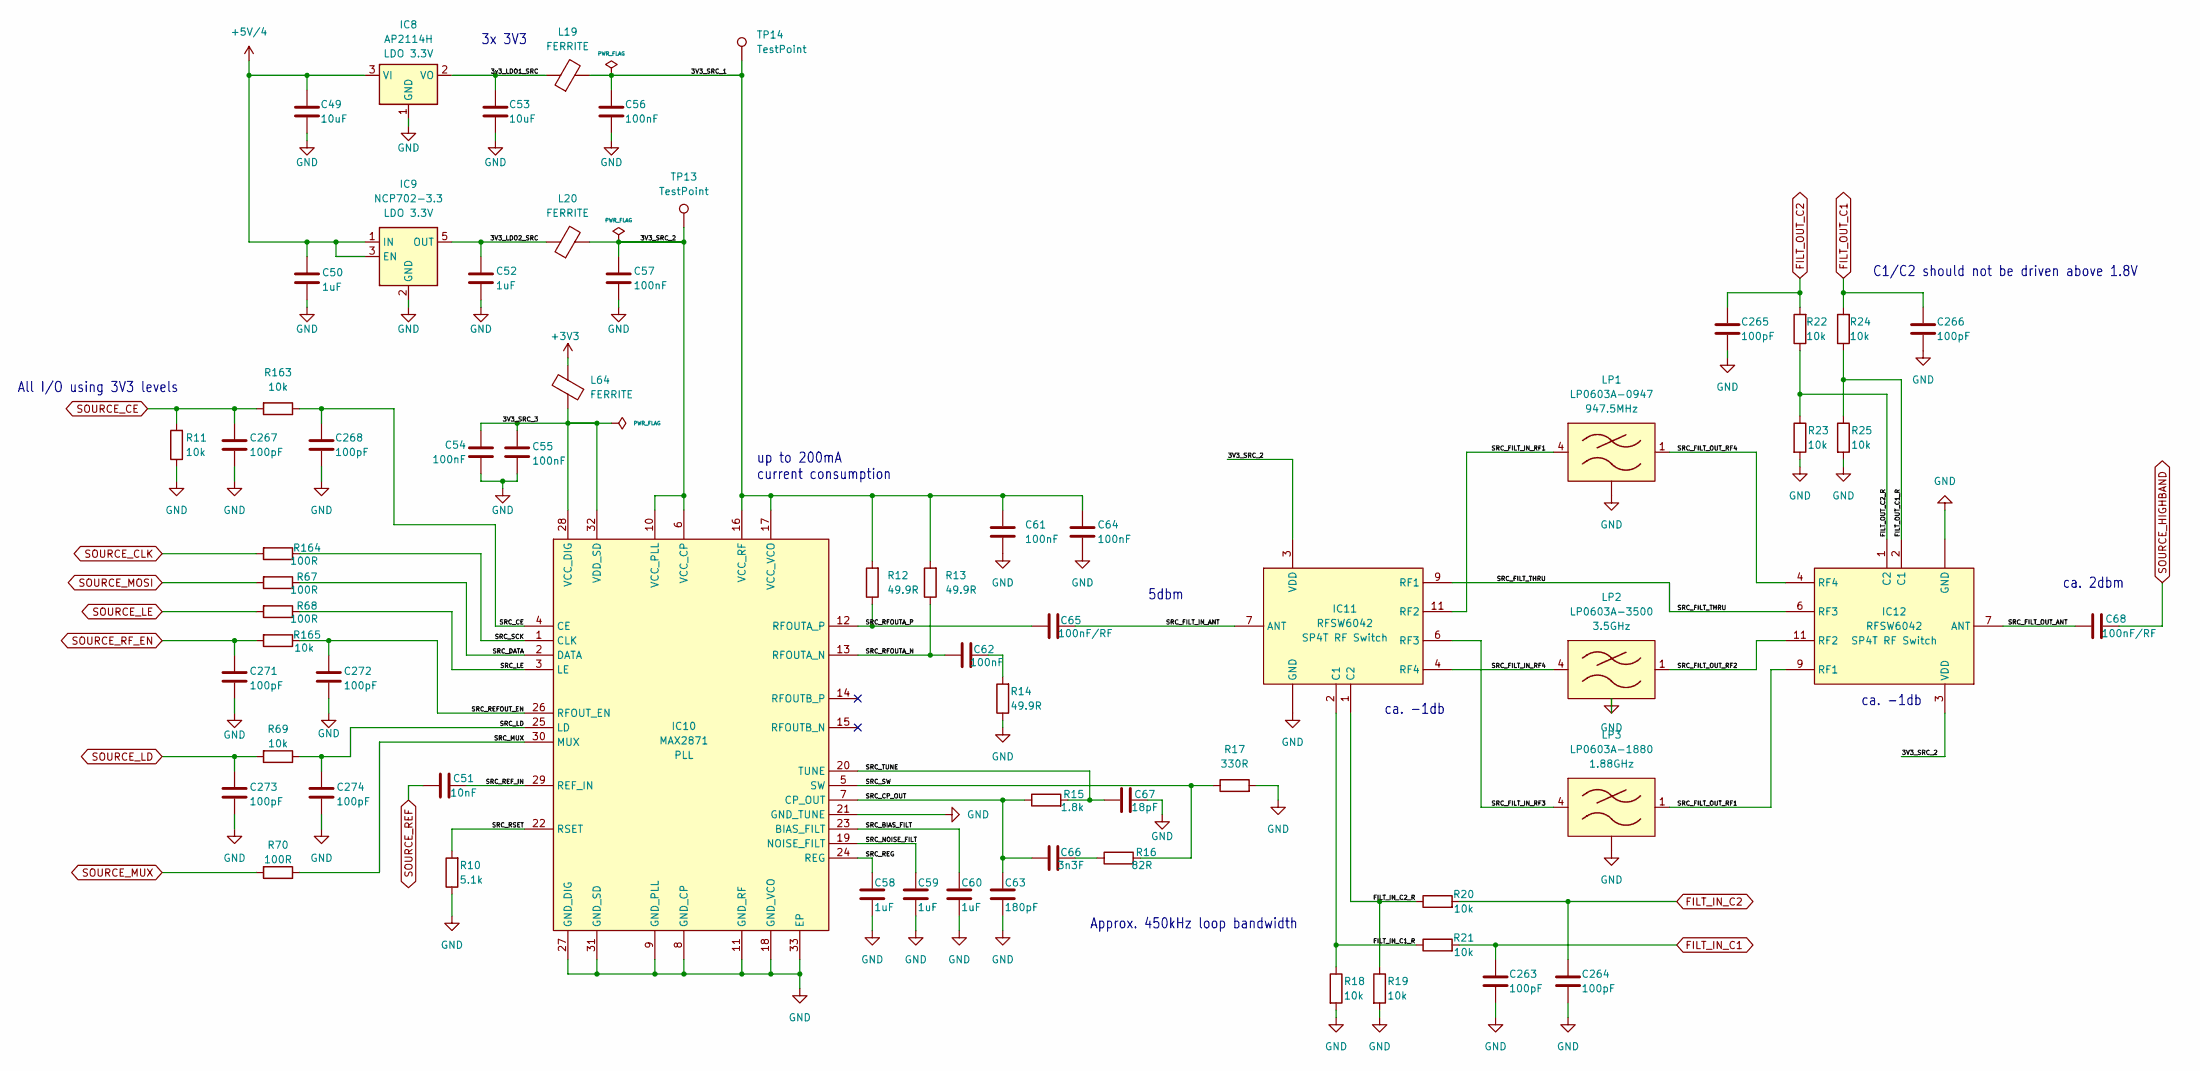
[picture p14: schematic HighFreqSource.kicad_sch, HF Source]

Parts:
C49, C53: 10uF; C_1206_3216Metric
C50, C52: 1uF; C_0603_1608Metric
C51: 10nF; C_0402_1005Metric
C54, C55, C56, C57, C61, C62, C64: 100nF; C_0402_1005Metric
C58, C59, C60: 1uF; C_0402_1005Metric
C63: 180pF; C_0402_1005Metric
C65, C68: 100nF/RF; C_0402_1005Metric
C66: 3n3F; C_0402_1005Metric
C67: 18pF; C_0402_1005Metric
C263, C264, C265, C266, C267, C268, C271, C272, C273, C274: 100pF; C_0402_1005Metric
IC8: AP2114H; SOT-223-3_TabPin2; MPN AP2114H-3.3TRG1
IC9: NCP702-3.3; SOT-23-5; MPN NCP702SN33T1G
IC10: MAX2871; QFN-32-1EP_5x5mm_P0.5mm_EP3.1x3.1mm; MPN MAX2871ETJ+
IC11, IC12: RFSW6042; QFN40P180X180X55-13T76N; MPN RFSW6042TR7
L19, L20, L64: FERRITE; R_0402_1005Metric; MPN BLM15AX601SN1
LP1: LP0603A-0947; FILTRDFN160X84X70-4N; MPN LP0603A0947ANTR
LP2: LP0603A-3500; FILTRDFN160X84X70-4N; MPN LP0603N3500ANTR
LP3: LP0603A-1880; FILTRDFN160X84X70-4N; MPN LP0603A1880ANTR
R10: 5.1k; R_0402_1005Metric
R11, R18, R19, R20, R21, R22, R23, R24, R25, R69, R163, R165: 10k; R_0402_1005Metric
R12, R13, R14: 49.9R; R_0402_1005Metric
R15: 1.8k; R_0402_1005Metric
R16: 82R; R_0402_1005Metric
R17: 330R; R_0402_1005Metric
R67, R68, R70, R164: 100R; R_0402_1005Metric
TP13, TP14: TestPoint; B1,27

Connections:
+3V3: L64.2; also elsewhere on the board
+5V/4: C49.1, C50.1, IC8.3 (VI), IC9.1 (IN), IC9.3 (EN); also elsewhere on the board
/HF Source/3V3_LDO2_SRC: C52.1, IC9.5 (OUT), L20.1
/HF Source/3V3_SRC_1: C56.1, C61.1, C64.1, IC10.16 (VCC_RF), IC10.17 (VCC_VCO), L19.2, R12.2, R13.2, TP14.1
/HF Source/3V3_SRC_2: C57.1, IC10.6 (VCC_CP), IC10.10 (VCC_PLL), IC11.3 (VDD), IC12.3 (VDD), L20.2, TP13.1
/HF Source/3V3_SRC_3: C54.1, C55.1, IC10.28 (VCC_DIG), IC10.32 (VDD_SD), L64.1
/HF Source/3v3_LDO1_SRC: C53.1, IC8.2 (VO), L19.1
/HF Source/FILT_IN_C1_R: IC11.2 (C1), R18.1, R21.1
/HF Source/FILT_IN_C2_R: IC11.1 (C2), R19.1, R20.1
/HF Source/FILT_OUT_C1_R: IC12.2 (C1), R24.1, R25.1
/HF Source/FILT_OUT_C2_R: IC12.1 (C2), R22.1, R23.1
/HF Source/SRC_BIAS_FILT: C60.1, IC10.23 (BIAS_FILT)
/HF Source/SRC_CE: C268.1, IC10.4 (CE), R163.1
/HF Source/SRC_CP_OUT: C63.1, C66.1, IC10.7 (CP_OUT), R15.1
/HF Source/SRC_DATA: IC10.2 (DATA), R67.1
/HF Source/SRC_FILT_IN_ANT: C65.2, IC11.7 (ANT)
/HF Source/SRC_FILT_IN_RF1: IC11.11 (RF2), LP1.4 (IN)
/HF Source/SRC_FILT_IN_RF3: IC11.6 (RF3), LP3.4 (IN)
/HF Source/SRC_FILT_IN_RF4: IC11.4 (RF4), LP2.4 (IN)
/HF Source/SRC_FILT_OUT_ANT: C68.1, IC12.7 (ANT)
/HF Source/SRC_FILT_OUT_RF1: IC12.9 (RF1), LP3.1 (OUT)
/HF Source/SRC_FILT_OUT_RF2: IC12.11 (RF2), LP2.1 (OUT)
/HF Source/SRC_FILT_OUT_RF4: IC12.4 (RF4), LP1.1 (OUT)
/HF Source/SRC_FILT_THRU: IC11.9 (RF1), IC12.6 (RF3)
/HF Source/SRC_LD: C274.1, IC10.25 (LD), R69.1
/HF Source/SRC_LE: IC10.3 (LE), R68.1
/HF Source/SRC_MUX: IC10.30 (MUX), R70.1
/HF Source/SRC_NOISE_FILT: C59.1, IC10.19 (NOISE_FILT)
/HF Source/SRC_REFOUT_EN: C272.1, IC10.26 (RFOUT_EN), R165.1
/HF Source/SRC_REF_IN: C51.2, IC10.29 (REF_IN)
/HF Source/SRC_REG: C58.1, IC10.24 (REG)
/HF Source/SRC_RFOUTA_N: C62.2, IC10.13 (RFOUTA_N), R13.1
/HF Source/SRC_RFOUTA_P: C65.1, IC10.12 (RFOUTA_P), R12.1
/HF Source/SRC_RSET: IC10.22 (RSET), R10.2
/HF Source/SRC_SCK: IC10.1 (CLK), R164.1
/HF Source/SRC_SW: IC10.5 (SW), R16.2, R17.1
/HF Source/SRC_TUNE: C67.2, IC10.20 (TUNE), R15.2
FILT_IN_C1: C263.1, R21.2; also elsewhere on the board
FILT_IN_C2: C264.1, R20.2; also elsewhere on the board
FILT_OUT_C1: C266.1, R24.2; also elsewhere on the board
FILT_OUT_C2: C265.1, R22.2; also elsewhere on the board
GND: C49.2, C50.2, C52.2, C53.2, C54.2, C55.2, C56.2, C57.2, C58.2, C59.2, C60.2, C61.2, C63.2, C64.2, C67.1, C263.2, C264.2, C265.2, C266.2, C267.2, C268.2, C271.2, C272.2, C273.2, C274.2, IC8.1 (GND), IC9.2 (GND), IC10.8 (GND_CP), IC10.9 (GND_PLL), IC10.11 (GND_RF), IC10.18 (GND_VCO), IC10.21 (GND_TUNE), IC10.27 (GND_DIG), IC10.31 (GND_SD), IC10.33 (EP), IC11.5 (GND), IC11.8 (GND), IC11.10 (GND), IC11.12 (GND), IC11.13 (GND), IC12.5 (GND), IC12.8 (GND), IC12.10 (GND), IC12.12 (GND), IC12.13 (GND), LP1.2 (GND), LP1.3 (GND), LP2.2 (GND), LP2.3 (GND), LP3.2 (GND), LP3.3 (GND), R10.1, R11.1, R14.1, R17.2, R18.2, R19.2, R23.2, R25.2; also elsewhere on the board
unnamed: C62.1, R14.2
unnamed: C66.2, R16.1
SOURCE_CE: C267.1, R11.2, R163.2; also elsewhere on the board
SOURCE_CLK: R164.2; also elsewhere on the board
SOURCE_HIGHBAND: C68.2; also elsewhere on the board
SOURCE_LD: C273.1, R69.2; also elsewhere on the board
SOURCE_LE: R68.2; also elsewhere on the board
SOURCE_MOSI: R67.2; also elsewhere on the board
SOURCE_MUX: R70.2; also elsewhere on the board
SOURCE_REF: C51.1; also elsewhere on the board
SOURCE_RF_EN: C271.1, R165.2; also elsewhere on the board

Notes on the sheet:
C1/C2 should not be driven above 1.8V
All I/O using 3V3 levels
3x 3V3
up to 200mA current consumption
ca. 2dbm
ca. -1db
5dbm
Approx. 450kHz loop bandwidth

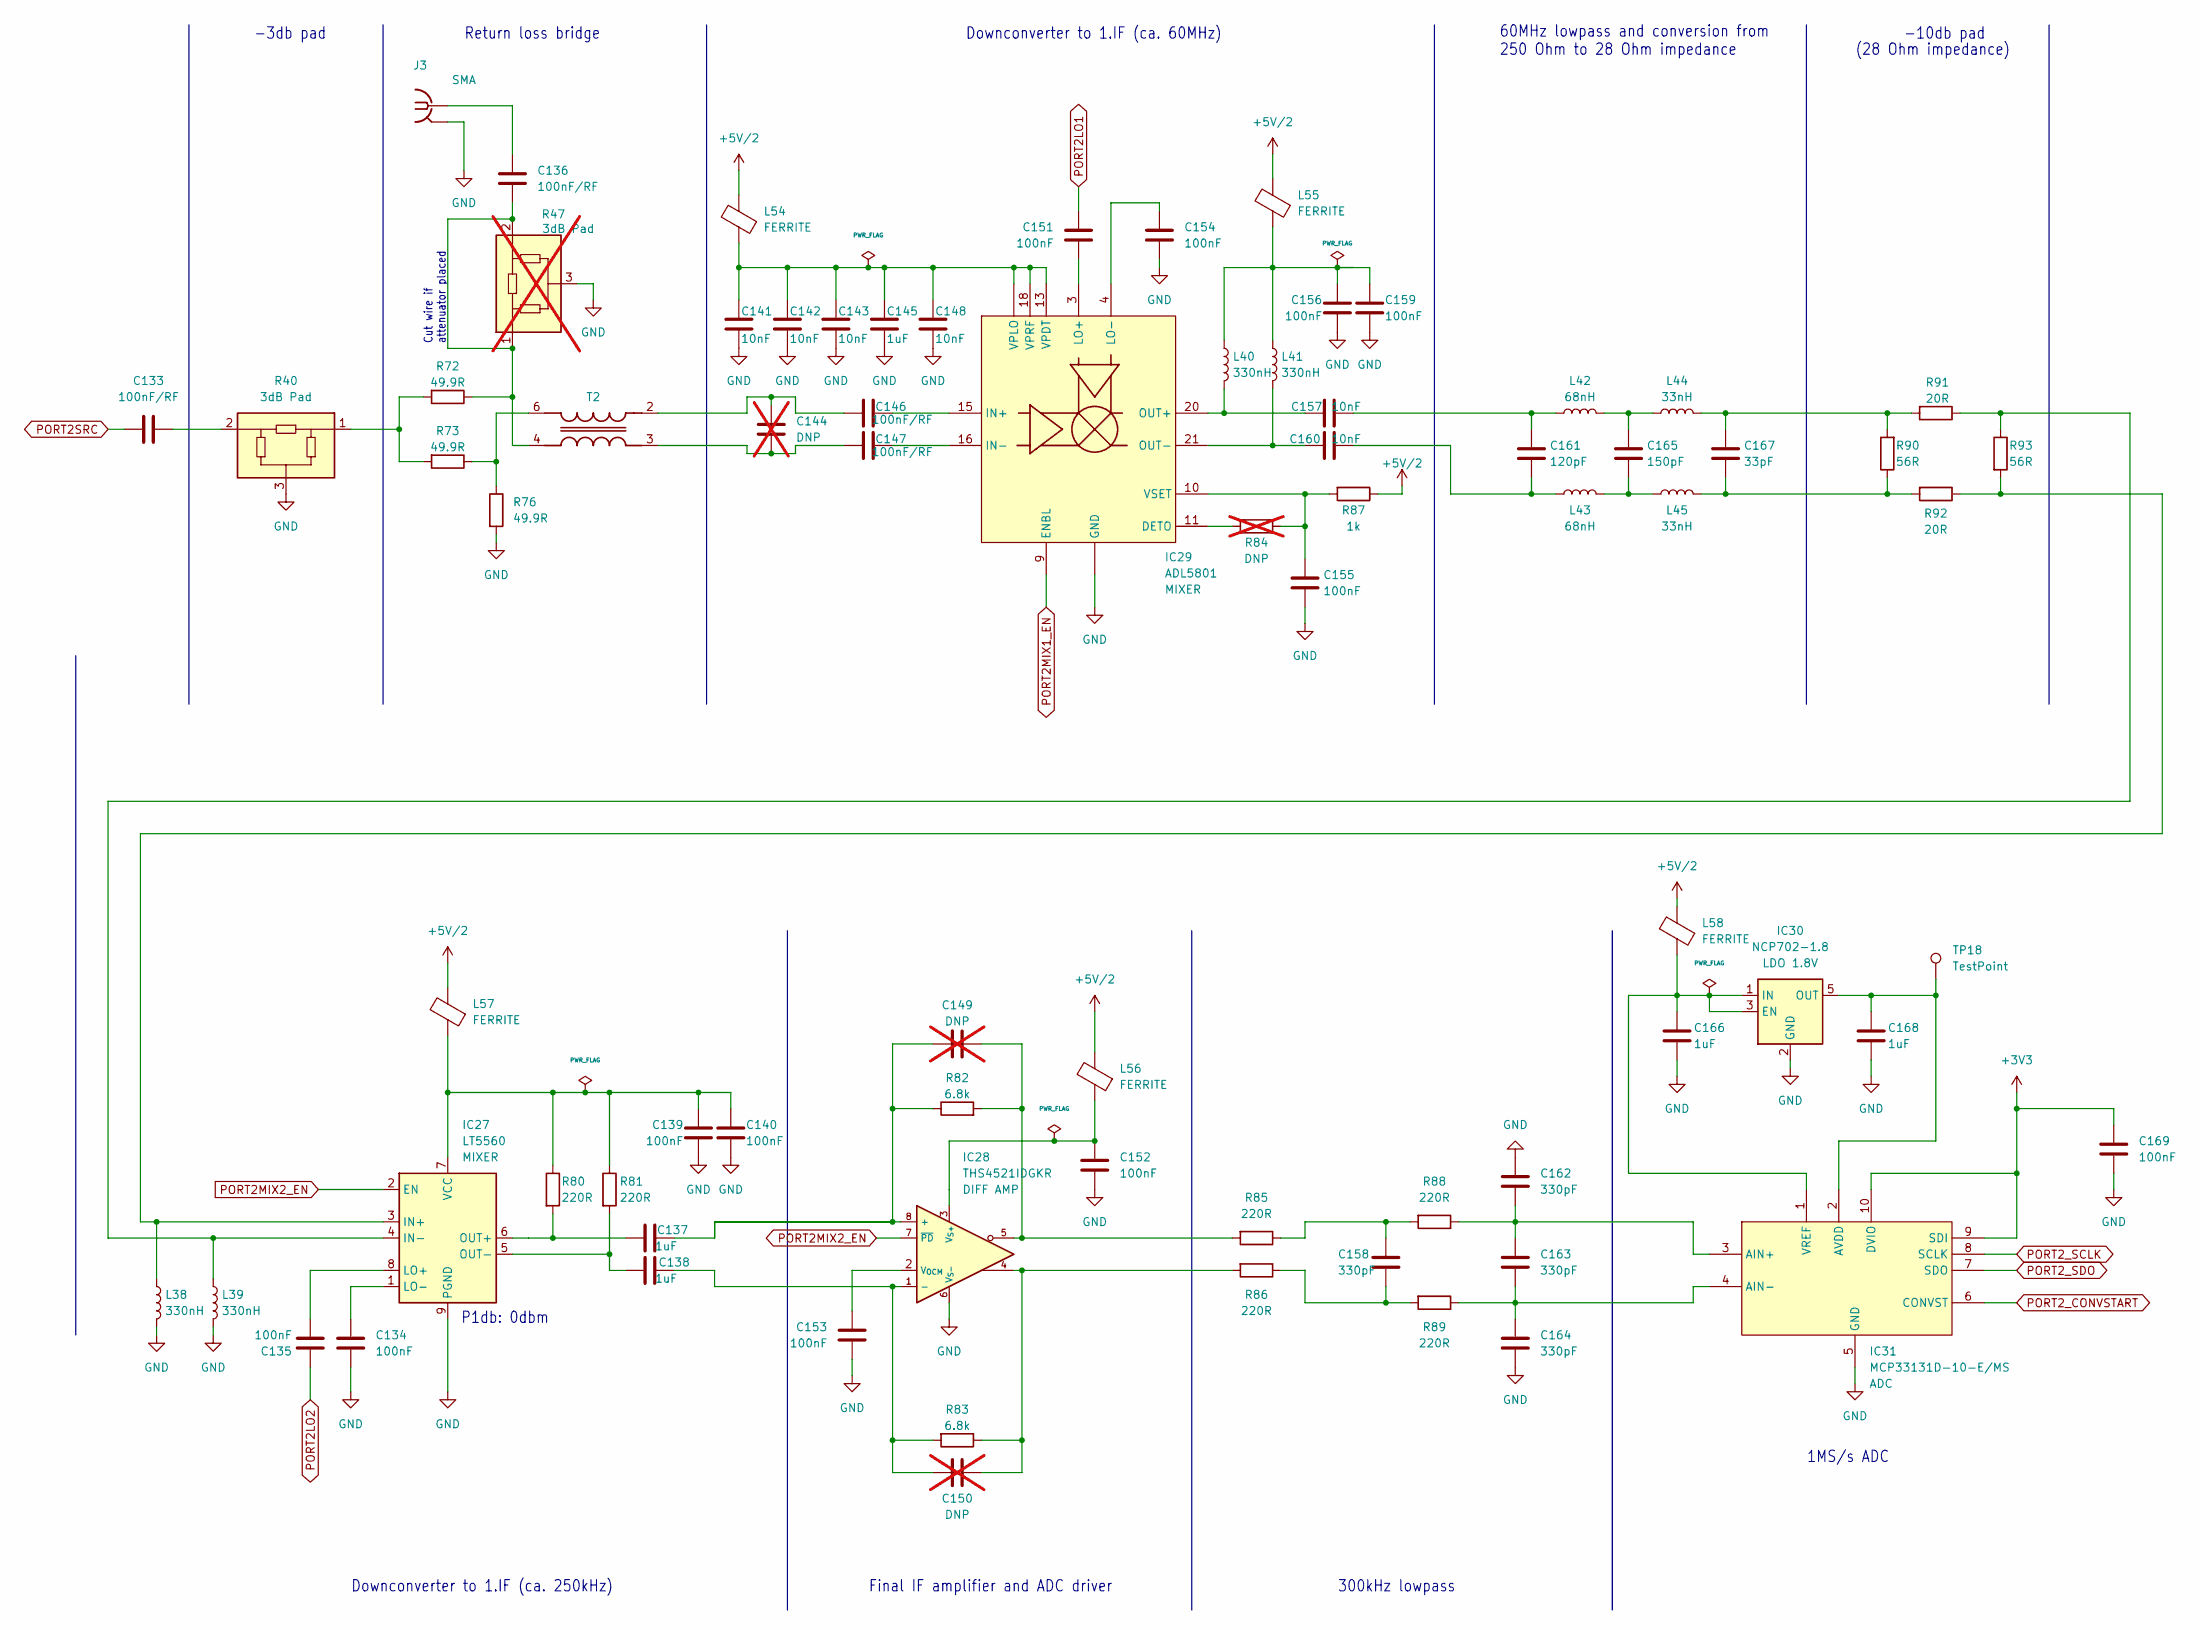
[picture p15: schematic Port2.kicad_sch, Port 2]

Parts:
C133, C136, C146, C147: 100nF/RF; C_0402_1005Metric
C134, C135, C139, C140, C151, C152, C153, C154, C155, C156, C159, C169: 100nF; C_0402_1005Metric
C137, C138, C145, C166, C168: 1uF; C_0402_1005Metric
C141, C142, C143, C148, C157, C160: 10nF; C_0402_1005Metric
C144, C149, C150: DNP; C_0402_1005Metric; not fitted
C158, C162, C163, C164: 330pF; C_0402_1005Metric
C161: 120pF; C_0402_1005Metric
C165: 150pF; C_0402_1005Metric
C167: 33pF; C_0402_1005Metric
IC27: LT5560; WSON-8-1EP_3x3mm_P0.5mm_EP1.45x2.4mm; MPN LT5560EDD
IC28: THS4521IDGKR; VSSOP-8_3.0x3.0mm_P0.65mm; MPN THS4521IDGKR
IC29: ADL5801; QFN-24-1EP_4x4mm_P0.5mm_EP2.6x2.6mm; MPN ADL5801
IC30: NCP702-1.8; SOT-23-5; MPN NCP702SN18T1G
IC31: MCP33131D-10-E/MS; VSSOP-10_3x3mm_P0.5mm; MPN MCP33131D-10-E/MS
J3: SMA; BU-1420701851; MPN AMPHENOL-132289
L38, L39, L40, L41: 330nH; L_0402_1005Metric; MPN LQW15CNR33J10D
L42, L43: 68nH; L_0402_1005Metric; MPN LQW15AN68NJ00D
L44, L45: 33nH; L_0402_1005Metric; MPN LQW15AN33NJ00D
L54, L55, L56, L57, L58: FERRITE; R_0402_1005Metric; MPN BLM15AX601SN1
R40: PAT0816-C-3DB-T5; PAT0816
R47: PAT0816-C-3DB-T5; PAT0816; not fitted
R72, R73, R76: 49.9R; R_0402_1005Metric
R80, R81, R85, R86, R88, R89: 220R; R_0402_1005Metric
R82, R83: 6.8k; R_0402_1005Metric
R84: DNP; R_0402_1005Metric; not fitted
R87: 1k; R_0402_1005Metric
R90, R93: 56R; R_0402_1005Metric
R91, R92: 20R; R_0402_1005Metric
T2: B012-617DB-1-63-B331; EASTEVER_BALUN; MPN B012-617DB-1-63-B331
TP18: TestPoint; B1,27

Connections:
+3V3: C169.2, IC31.9 (SDI), IC31.10 (DVIO); also elsewhere on the board
+5V/2: L54.2, L55.2, L56.2, L57.2, L58.2, R87.1; also elsewhere on the board
GND: C134.1, C139.1, C140.1, C141.2, C142.2, C143.2, C145.2, C148.2, C152.1, C153.2, C154.2, C155.1, C156.2, C159.2, C162.1, C164.2, C166.2, C168.2, C169.1, IC27.9 (PGND), IC28.6 (V_{S-}), IC29.1 (GND), IC29.2 (GND), IC29.5 (GND), IC29.6 (GND), IC29.8 (GND), IC29.12 (GND), IC29.14 (GND), IC29.17 (GND), IC29.19 (GND), IC29.23 (GND), IC29.25 (GND), IC30.2 (GND), IC31.5 (GND), J3.G@1 (2), J3.G@2 (2), J3.G@3 (2), J3.G@4 (2), L38.2, L39.2, R40.3, R47.3, R76.2; also elsewhere on the board
unnamed: C133.2, R40.2
unnamed: C136.1, J3.1
unnamed: C149.2, IC28.5, R82.2, R85.2
unnamed: C150.1, IC28.4, R83.1, R86.2
unnamed: C156.1, C159.1, L40.1, L41.1, L55.1
unnamed: C157.2, C161.1, L42.1
unnamed: C158.1, R85.1, R88.2
unnamed: C158.2, R86.1, R89.2
unnamed: C160.2, C161.2, L43.1
unnamed: C165.1, L42.2, L44.1
unnamed: C165.2, L43.2, L45.1
unnamed: C167.1, L44.2, R90.2, R91.2
unnamed: C167.2, L45.2, R90.1, R92.2
unnamed: IC27.3 (IN+), L38.1, R92.1, R93.2
unnamed: IC27.4 (IN-), L39.1, R91.1, R93.1
unnamed: C135.2, IC27.8 (LO+)
unnamed: C134.2, IC27.1 (LO-)
unnamed: C137.1, IC27.6 (OUT+), R80.2
unnamed: C138.1, IC27.5 (OUT-), R81.2
unnamed: C139.2, C140.2, IC27.7 (VCC), L57.1, R80.1, R81.1
unnamed: C137.2, C149.1, IC28.8 (+), R82.1
unnamed: C138.2, C150.2, IC28.1 (-), R83.2
unnamed: C153.1, IC28.2 (V_{OCM})
unnamed: C152.2, IC28.3 (V_{S+}), L56.1
unnamed: IC29.11 (DETO), R84.2
unnamed: C146.2, IC29.15 (IN+)
unnamed: C147.2, IC29.16 (IN-)
unnamed: C151.2, IC29.3 (LO+)
unnamed: C154.1, IC29.4 (LO-)
unnamed: C157.1, IC29.20 (OUT+), L40.2
unnamed: C160.1, IC29.21 (OUT-), L41.2
unnamed: C141.1, C142.1, C143.1, C145.1, C148.1, IC29.7 (VPLO), IC29.13 (VPDT), IC29.18 (VPRF), IC29.24 (VPLO), L54.1
unnamed: C155.2, IC29.10 (VSET), R84.1, R87.2
unnamed: C166.1, IC30.1 (IN), IC30.3 (EN), IC31.1 (VREF), L58.1
unnamed: C168.1, IC30.5 (OUT), IC31.2 (AVDD), TP18.1
unnamed: C162.2, C163.1, IC31.3 (AIN+), R88.1
unnamed: C163.2, C164.1, IC31.4 (AIN-), R89.1
unnamed: R40.1, R72.2, R73.2
unnamed: C144.1, C147.1, T2.3 (IN+)
unnamed: C144.2, C146.1, T2.2 (IN-)
unnamed: C136.2, R47.1, R47.2, R72.1, T2.4 (OUT+)
unnamed: R73.1, R76.1, T2.6 (OUT-)
PORT2LO1: C151.1; also elsewhere on the board
PORT2LO2: C135.1; also elsewhere on the board
PORT2MIX1_EN: IC29.9 (ENBL); also elsewhere on the board
PORT2MIX2_EN: IC27.2 (EN), IC28.7 (~PD); also elsewhere on the board
PORT2SRC: C133.1; also elsewhere on the board
PORT2_CONVSTART: IC31.6 (CONVST); also elsewhere on the board
PORT2_SCLK: IC31.8 (SCLK); also elsewhere on the board
PORT2_SDO: IC31.7 (SDO); also elsewhere on the board

Notes on the sheet:
1MS/s ADC
-10db pad
Downconverter to 1.IF (ca. 60MHz)
Return loss bridge
-3db pad
60MHz lowpass and conversion from 250 Ohm to 28 Ohm impedance
300kHz lowpass
Final IF amplifier and ADC driver
P1db: 0dbm
(28 Ohm impedance)
Downconverter to 1.IF (ca. 250kHz)
Cut wire if attenuator placed

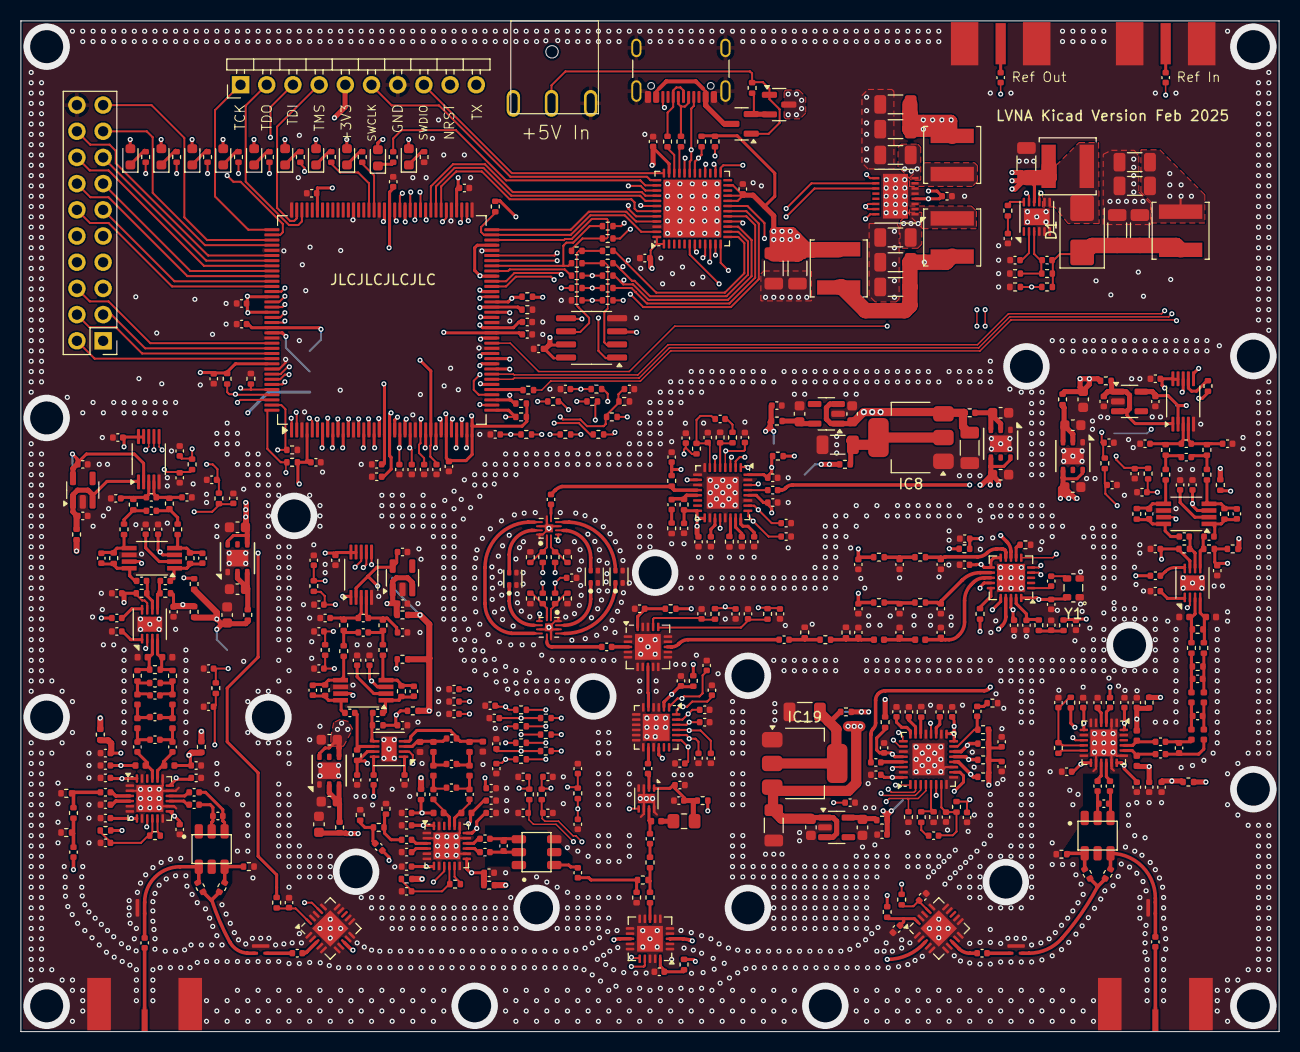
[picture p16: board VNA.kicad_pcb from above]

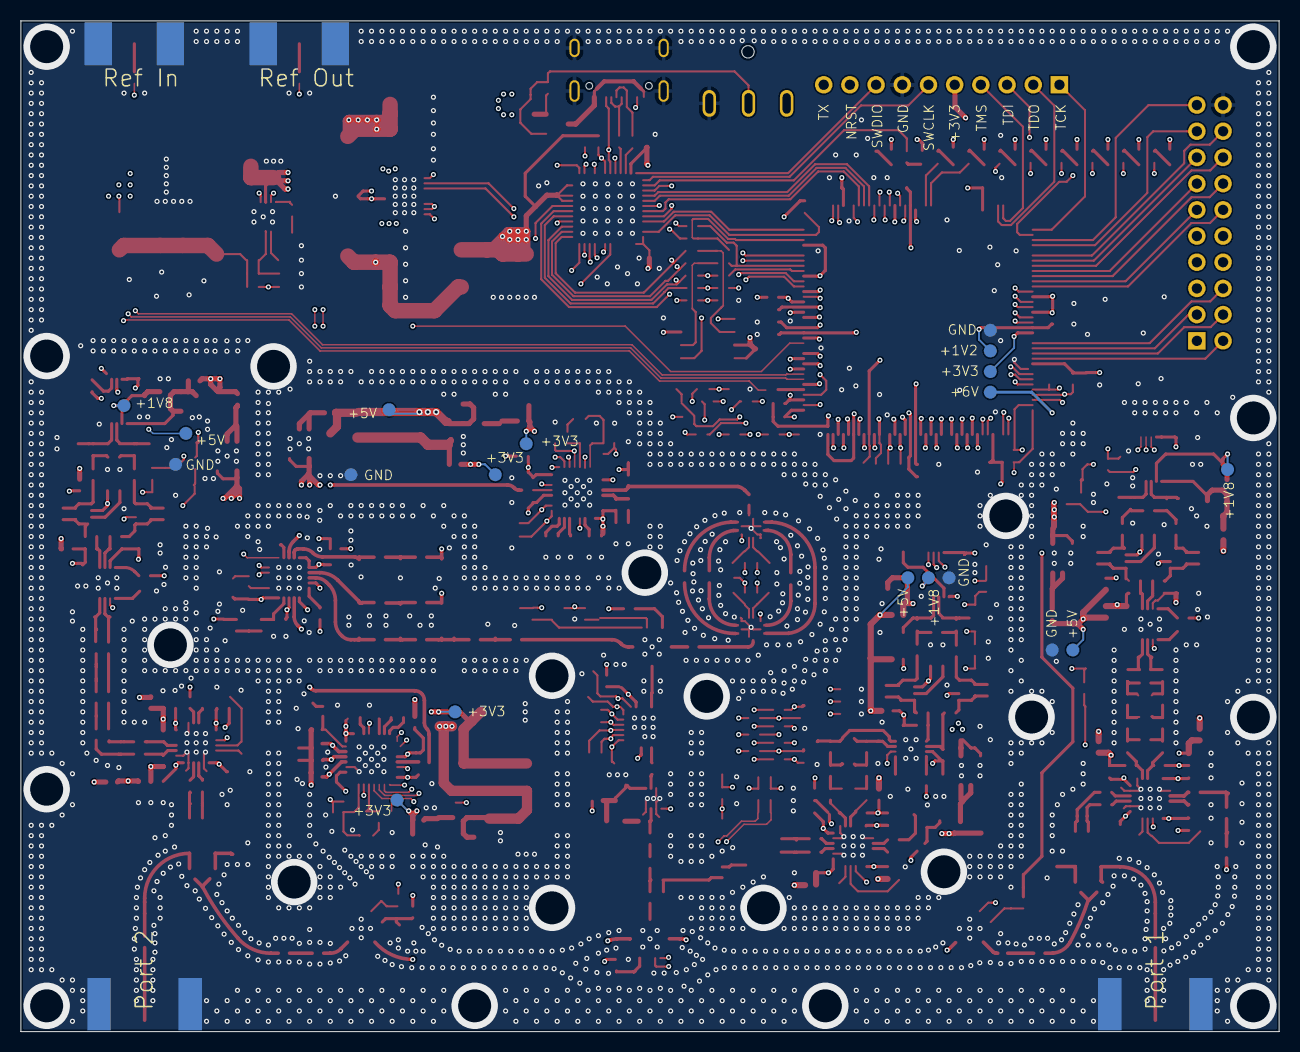
[picture p17: board VNA.kicad_pcb from below]

Board: 6 copper layers, 122.0 x 98.0 mm, 592 parts (20 on the bottom side), 402 nets.
